MarkVerbeek91/AR2/docs/doc/source/requirements_document.rst

=====================
Requirement document
=====================

The program should have a graphical interface
The program should have a command line interface
The program should have a ROS interface

the user can create a new program
the user can load a existing program
the user can add a command to loaded program
the user can remove a command from the load program
the user can save the program 

the programmer can add program lines to a program list
the programmer can remove program lines from a program list
the programmer can send a program to the controller
the programmer is not blocked be the call to the controller
the programmer returns an error message when the controller is running 

the controller can send commands to the arduino
the controller can receive commands from the arduino
the controller has a running state
the controller has a stop state
