MarkVerbeek91/AR2/docs/doc/source/index.rst

.. AR2 documentation master file, created by
   sphinx-quickstart on Tue Nov 21 14:47:20 2017.
   You can adapt this file completely to your liking, but it should at least
   contain the root `toctree` directive.

Welcome to AR2's documentation!
===============================

.. toctree::
  :maxdepth: 2
  :caption: Contents:
    
  protocol
  uml_page

Here all documentation for the AR2 robotic arm made by Chriss Annin.  

Indices and tables
==================

* :ref:`genindex`
* :ref:`modindex`
* :ref:`search`
