MarkVerbeek91/AR2/docs/doc/source/protocol.rst

================
Serial protocol
================

+--------------+--------------+--------------+
| Main command | Function     | Parameters   |
+--------------+--------------+--------------+
| SV           | Turn on      |              |
+--------------+--------------+--------------+
| WT           |              |              |
+--------------+--------------+--------------+
| JF           |              |              |
+--------------+--------------+--------------+
| ON           |              |              |
+--------------+--------------+--------------+
| OF           |              |              |
+--------------+--------------+--------------+
| WI           |              |              |
+--------------+--------------+--------------+
| WO           |              |              |
+--------------+--------------+--------------+
| LL           |              |              |
+--------------+--------------+--------------+
| MJ           |              |              |
+--------------+--------------+--------------+

.. csv-table:: Protocol
  :widths: 4 20 20
  :header: "Main command", "Function", "Parameters"
  
  "SV", "Turn on/off servo", "Servo nr and servo position"
