MarkVerbeek91/AR2/AR2.1.4 kinematic model.xlsm

FORWARD KINAMATICS |  |  |  |  |  |  |  |  |  | INVERSE KINAMATICS
 | IN |  |  |  |  |  | OUT |  |  |  | IN
 | degrees | radians
J1 * ( -170 / 170 ) | 0.0001 | 1.745329252e-06 |  |  |  | X | 68.71814224 |  |  | X | 68.71814224 | J1 | 9.999999996e-05
J2 * ( -132 / 0 ) | -90 | -1.570796327 |  |  |  | Y | 0.0001199357837 |  |  | Y | 0.0001199357837 | J2 | -90
J3 * ( 1 / 140 ) | 1 | -1.553343034 |  |  |  | Z | 733.6105702 |  |  | Z | 733.6105702 | J3 | 1
 | 0 | 0 |  |  |  | y | -90 | -1.570796327 |  | y | -90 | J4 | -3.113901077e-10 | -3.113901077e-10 | 180
 | 0.0001 | 1.745329252e-06 |  |  |  | p | 1.0001 | 0.01745503785 |  | p | 1.0001 | J5 | 9.999727019e-05 | 9.999727019e-05 | -9.999727019e-05 |  | WRIST CONF. | "F"
 | 0 | 3.141592654 |  |  |  | r | -90.0001 | -1.570798072 |  | r | -90.0001 | J6 | 3.113598268e-10 | 3.113598268e-10 | -180 |  | QUADRANT | 1
 | DH params
 | joint | Θ | α | d | a |  | WORK FRAME |  | TOOL FRAME | CALCULATE J1 ANGLE
 | 1 | 1.745329252e-06 | -1.570796327 | 169.77 | 64.2 | X | 0 | X | 0 | J1 ∠ | 1.745329251e-06 | 9.999999996e-05
 | 2 | -1.570796327 | 0 | 0 | 305 | Y | 0 | Y | 0
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
