MarkVerbeek91/AR2/CAD/J5 main bearing housing.STEP

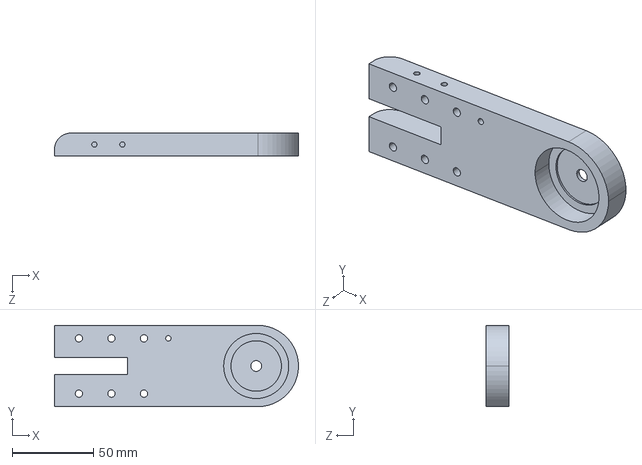
[picture p1: CAD file, 2017-11-05]
CAD/J5 main bearing housing.STEP
150.0 x 50.0 x 14.0 mm
