MarkVerbeek91/AR2/CAD/J6 main bearing arm.STEP

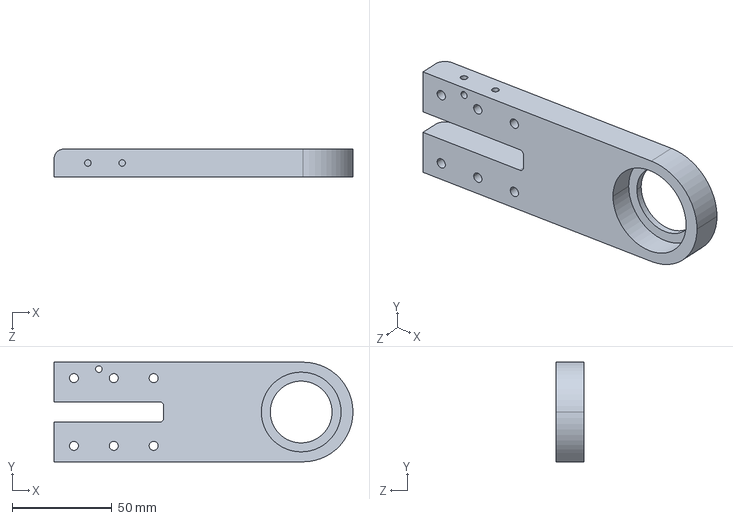
[picture p2: CAD file, 2017-11-05]
CAD/J6 main bearing arm.STEP
150.0 x 50.0 x 14.0 mm
