MarkVerbeek91/AR2/CAD/J4 main shaft.STEP

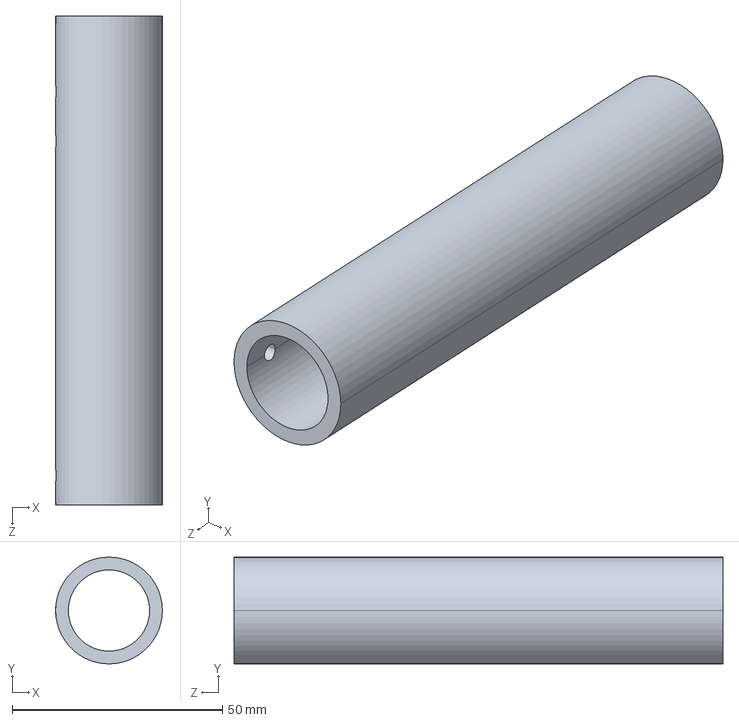
[picture p3: CAD file, 2017-11-05]
CAD/J4 main shaft.STEP
25.4 x 25.4 x 116.3 mm
