MarkVerbeek91/AR2/CAD/J2 turret housing.STEP

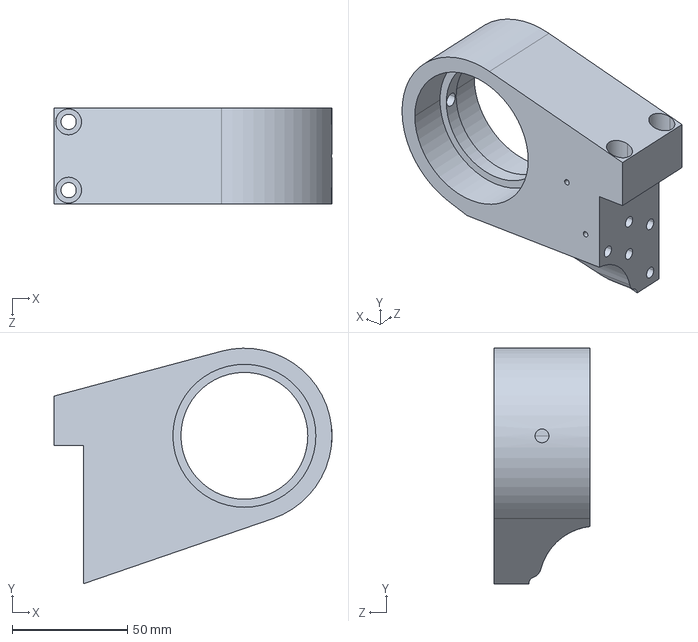
[picture p4: CAD file, 2017-11-05]
CAD/J2 turret housing.STEP
120.6 x 102.2 x 41.6 mm
