MarkVerbeek91/AR2/stl/J2 arm part 1.STL

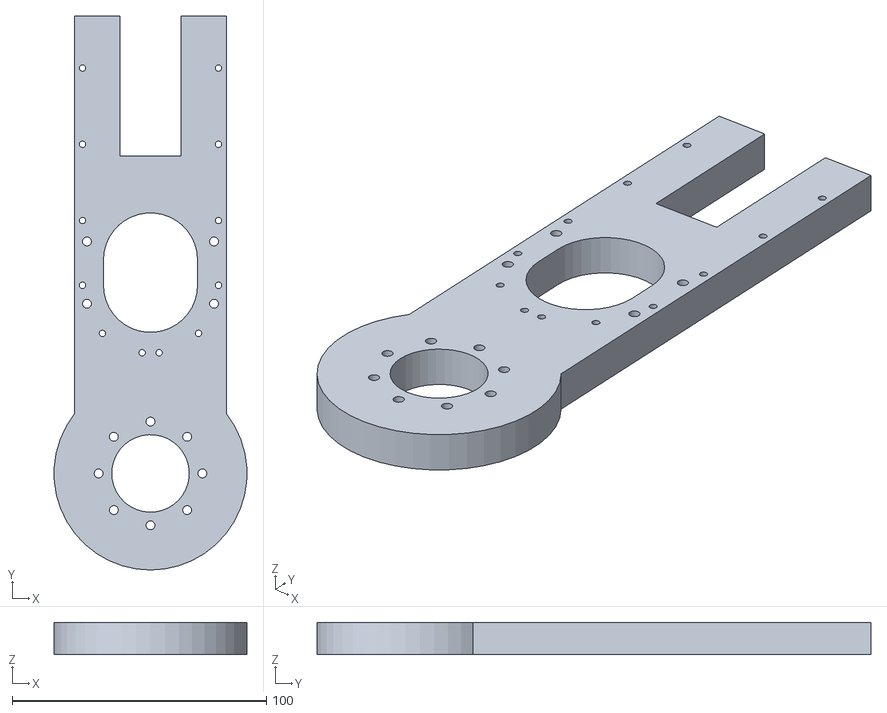
[picture p5: CAD file, 2017-11-05]
stl/J2 arm part 1.STL
75.8 x 218.0 x 12.7
