MarkVerbeek91/AR2/CAD/J2 drive spindle .STEP

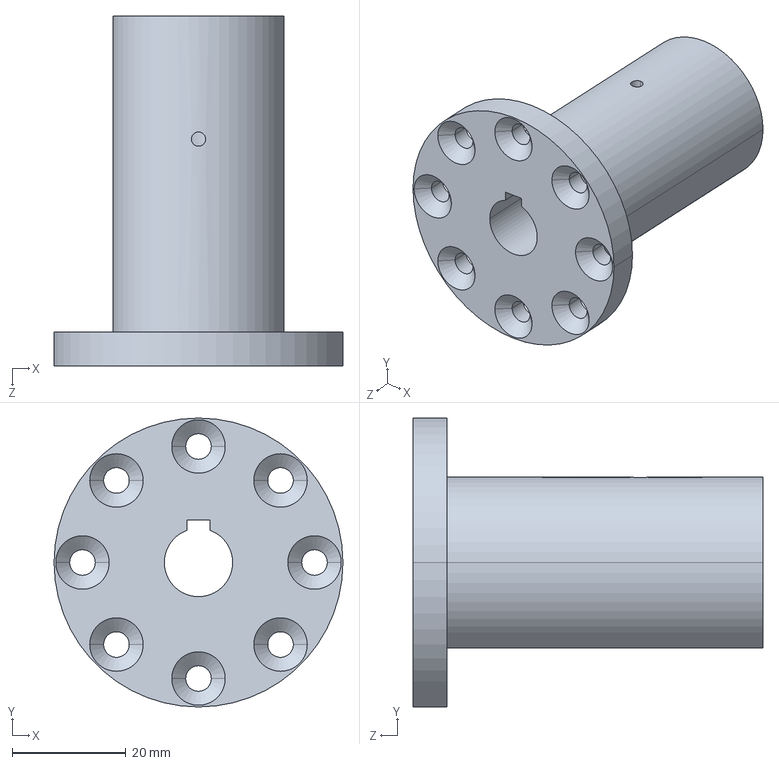
[picture p6: CAD file, 2017-11-05]
CAD/J2 drive spindle .STEP
50.8 x 50.8 x 61.5 mm
