MarkVerbeek91/AR2/stl/J2 tension ring - 14mm for precision GB.STL

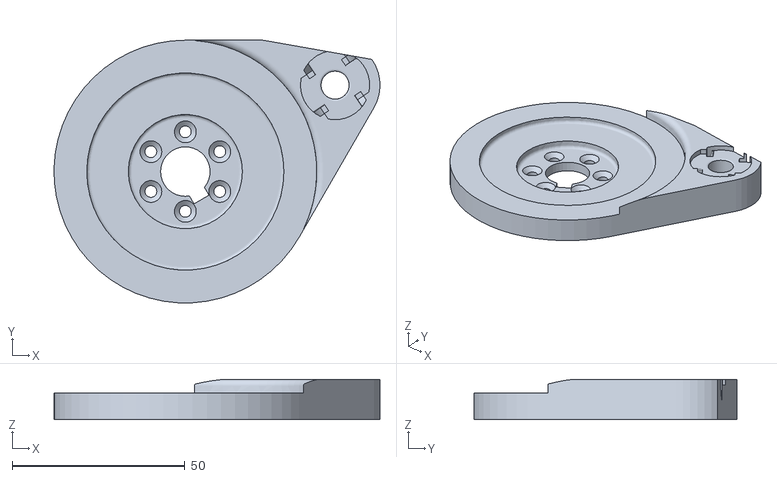
[picture p7: CAD file, 2017-11-05]
stl/J2 tension ring - 14mm for precision GB.STL
94.3 x 75.9 x 11.7
