MarkVerbeek91/AR2/stl/J1 spindle center alignment plug.STL

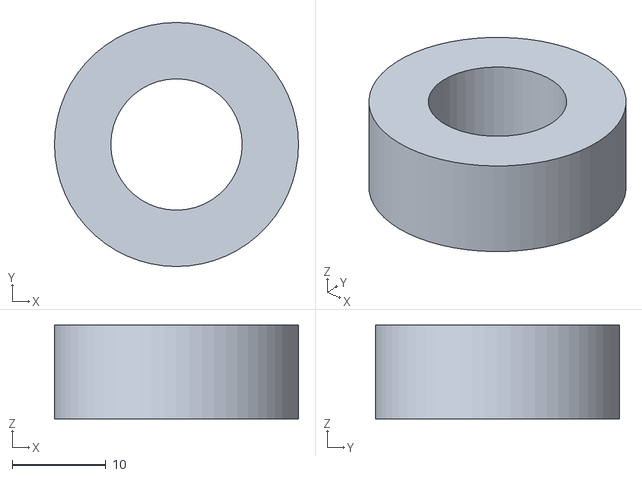
[picture p8: CAD file, 2017-11-05]
stl/J1 spindle center alignment plug.STL
26.0 x 26.0 x 10.0
