MarkVerbeek91/AR2/CAD/J5 side cover.STEP

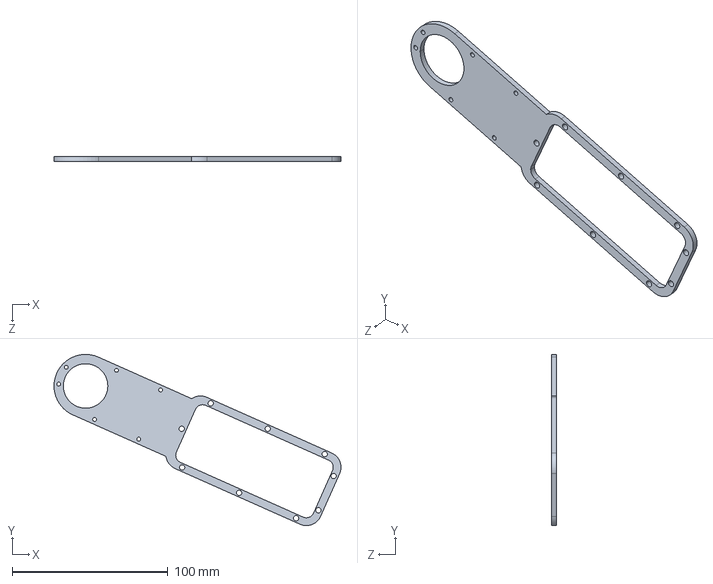
[picture p9: CAD file, 2017-11-05]
CAD/J5 side cover.STEP
184.0 x 109.7 x 3.17 mm
