MarkVerbeek91/AR2/stl/J1 base support spacer part 1.STL

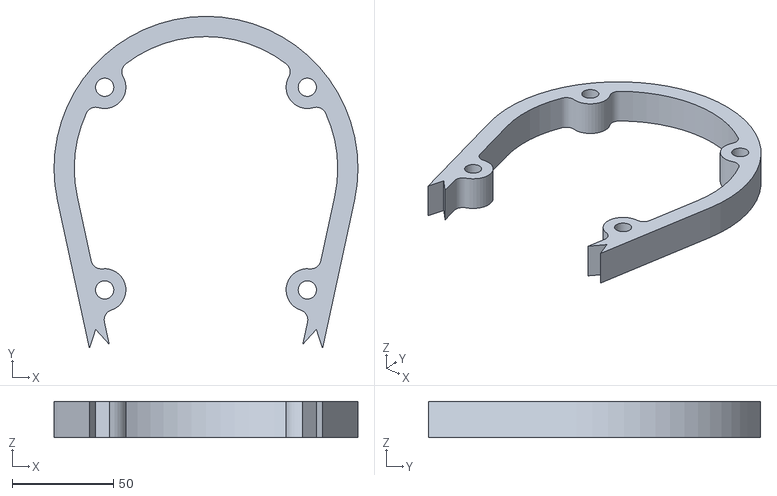
[picture p10: CAD file, 2017-11-05]
stl/J1 base support spacer part 1.STL
150.0 x 164.0 x 18.0
