MarkVerbeek91/AR2/CAD/J1 turret platform.STEP

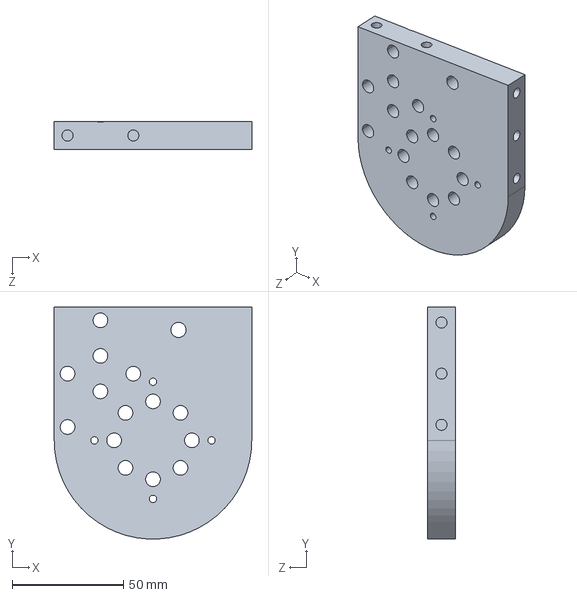
[picture p11: CAD file, 2017-11-05]
CAD/J1 turret platform.STEP
88.9 x 104.4 x 12.7 mm
