MarkVerbeek91/AR2/stl/J1 base plate part 1.STL

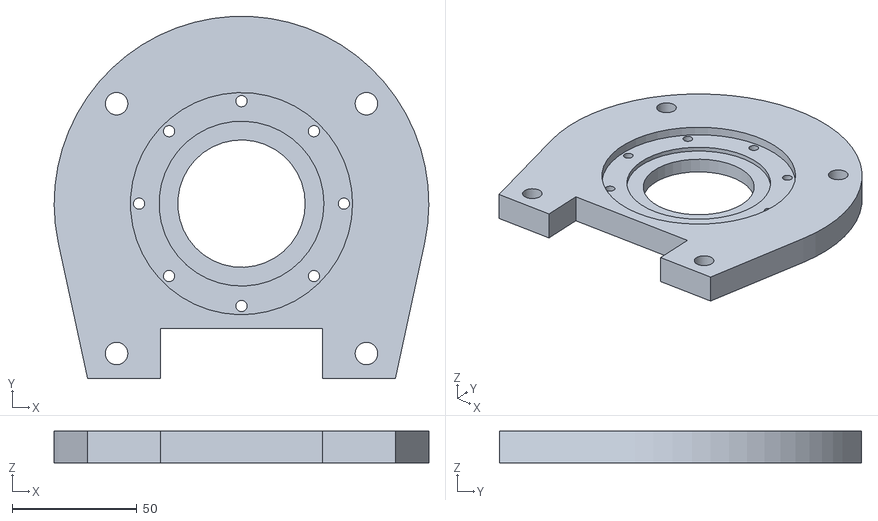
[picture p12: CAD file, 2017-11-05]
stl/J1 base plate part 1.STL
150.0 x 144.9 x 12.7
