MarkVerbeek91/AR2/CAD/J2 arm cover spacer.STEP

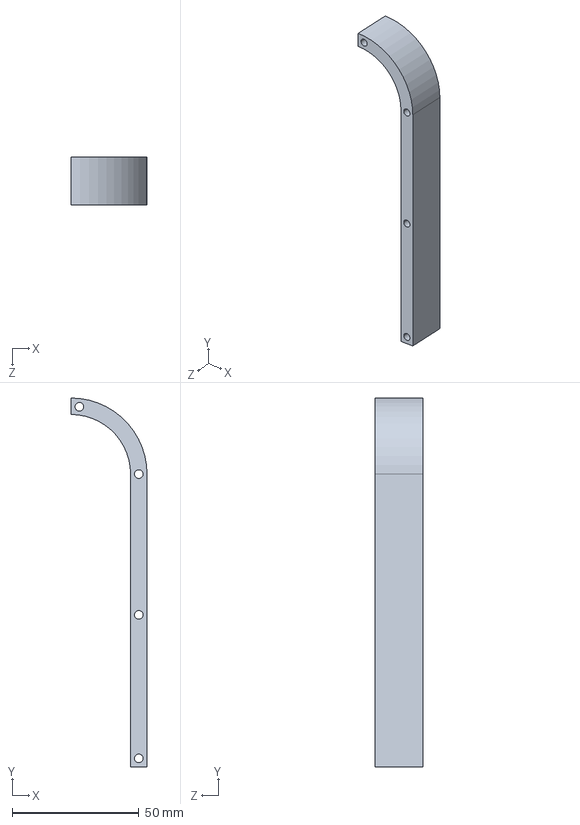
[picture p13: CAD file, 2017-11-05]
CAD/J2 arm cover spacer.STEP
30.0 x 145.5 x 19.1 mm
