MarkVerbeek91/AR2/stl/J1 base plate part 2.STL

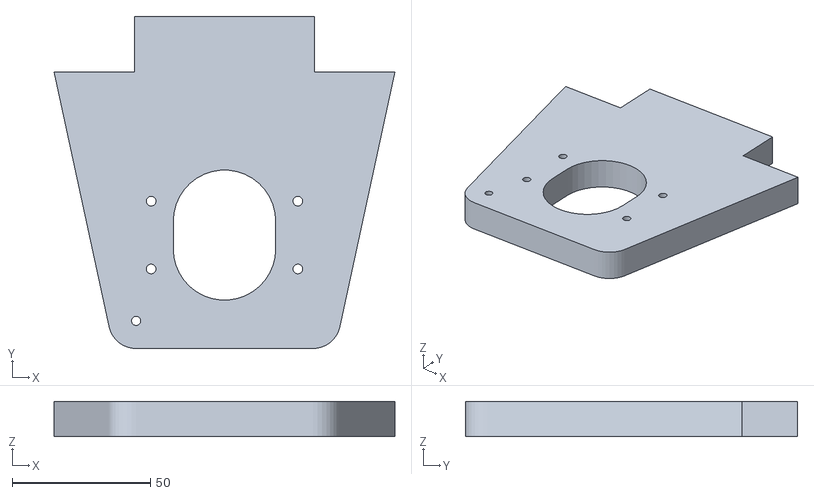
[picture p14: CAD file, 2017-11-05]
stl/J1 base plate part 2.STL
123.2 x 120.0 x 12.7
