MarkVerbeek91/AR2/CAD/J3 spindle.STEP

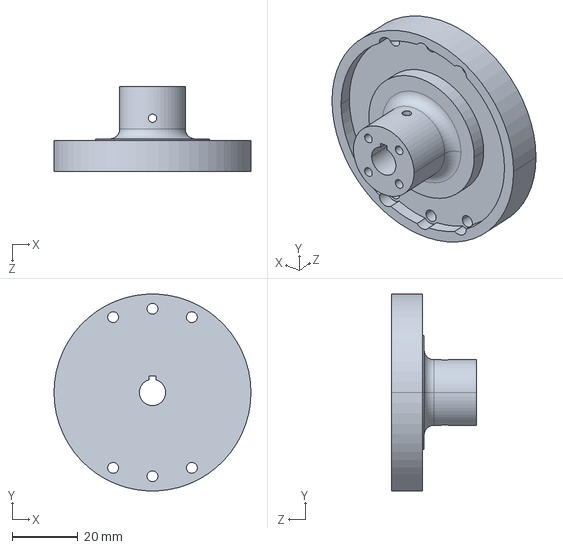
[picture p15: CAD file, 2017-11-05]
CAD/J3 spindle.STEP
60.0 x 59.9 x 26.0 mm
