MarkVerbeek91/AR2/stl/J2 arm part 2.STL

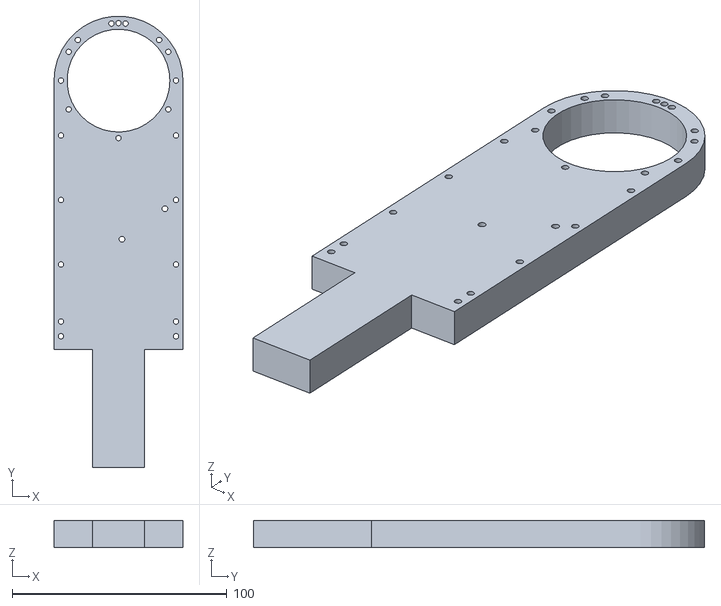
[picture p16: CAD file, 2017-11-05]
stl/J2 arm part 2.STL
60.0 x 209.9 x 12.7
