MarkVerbeek91/AR2/CAD/J6 bearing cap.STEP

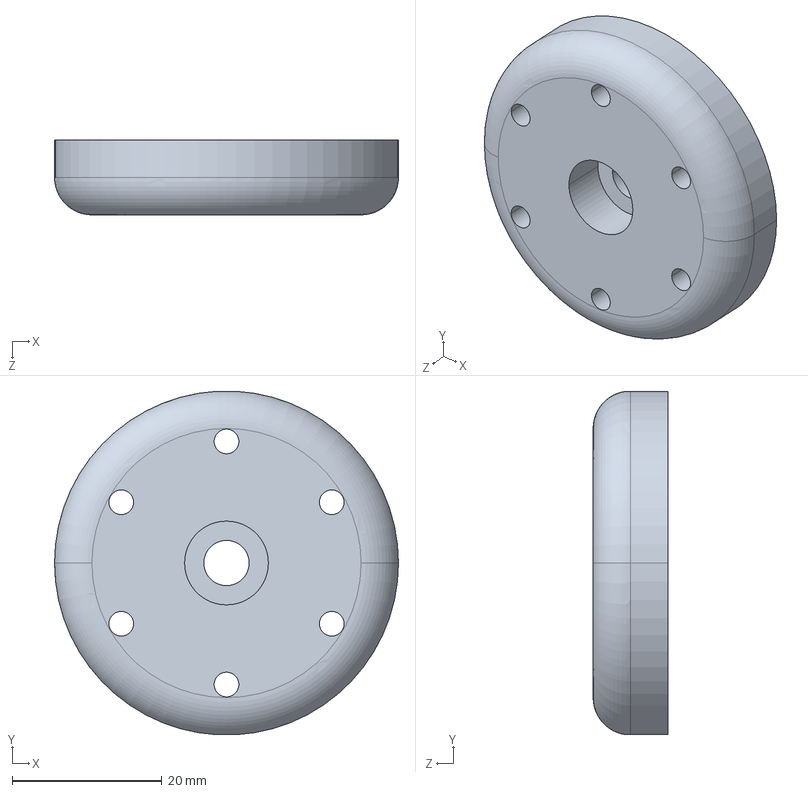
[picture p17: CAD file, 2017-11-05]
CAD/J6 bearing cap.STEP
46.0 x 45.9 x 10.0 mm
