MarkVerbeek91/AR2/stl/auxilliary J2 arm support.STL

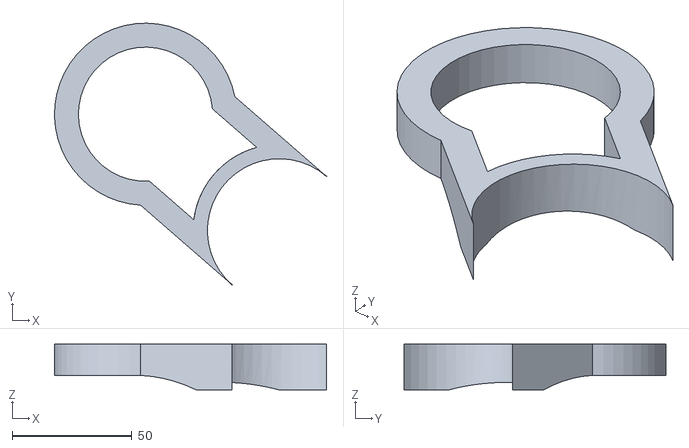
[picture p18: CAD file, 2017-11-05]
stl/auxilliary J2 arm support.STL
113.5 x 109.2 x 19.0
