MarkVerbeek91/AR2/CAD/J3 bearing cup.STEP

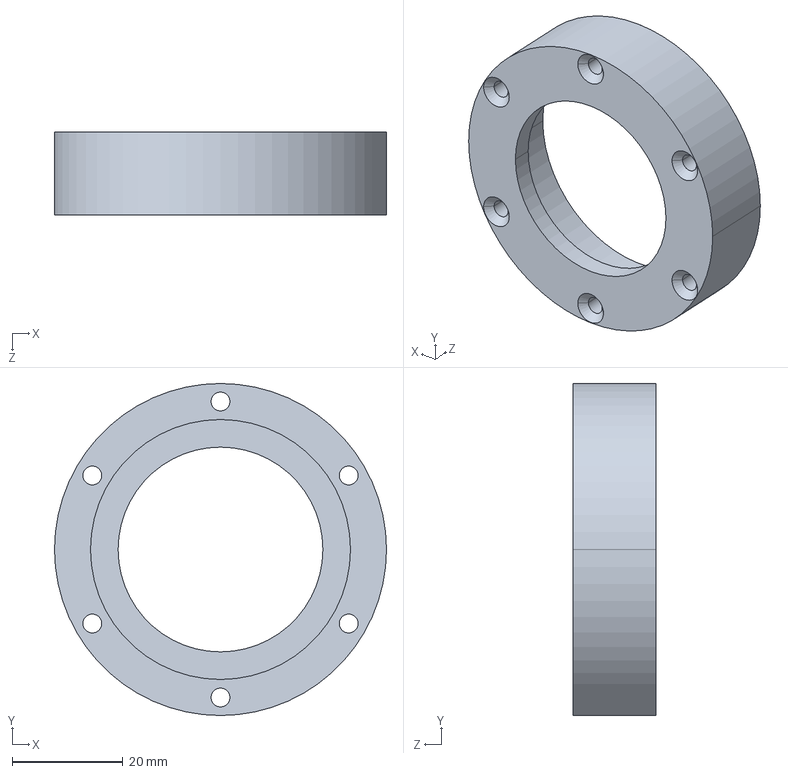
[picture p19: CAD file, 2017-11-05]
CAD/J3 bearing cup.STEP
60.0 x 60.0 x 15.0 mm
