MarkVerbeek91/AR2/stl/auxilliary spring housing support.STL

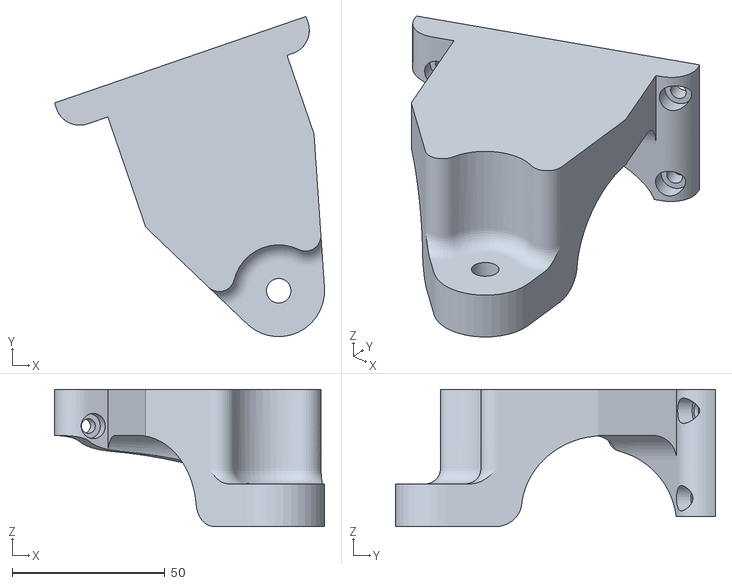
[picture p20: CAD file, 2017-11-05]
stl/auxilliary spring housing support.STL
88.3 x 104.6 x 44.9
