MarkVerbeek91/AR2/CAD/J5 idler tension block.STEP

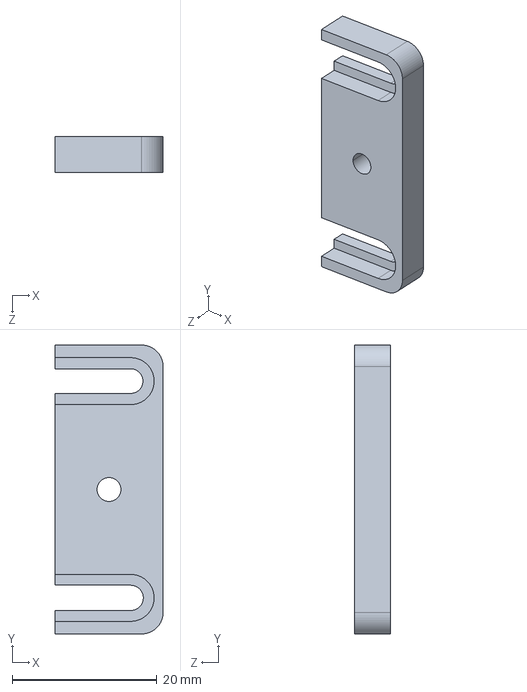
[picture p21: CAD file, 2017-11-05]
CAD/J5 idler tension block.STEP
15.0 x 40.0 x 5.00 mm
