MarkVerbeek91/AR2/stl/J2 drive spindle - 14mm for precision GB .STL

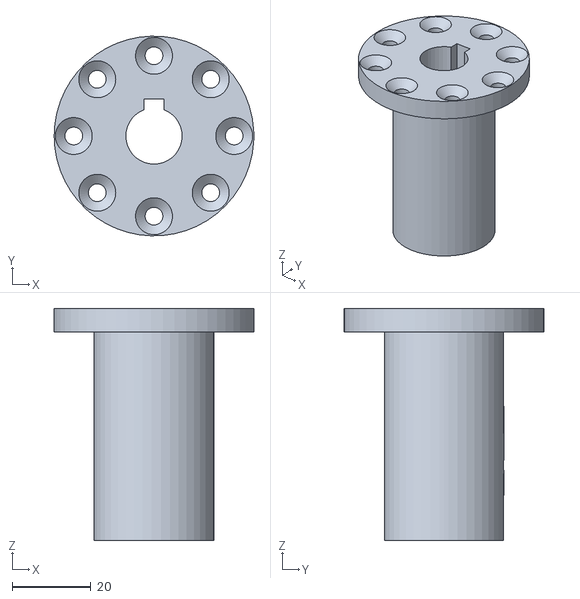
[picture p22: CAD file, 2017-11-05]
stl/J2 drive spindle - 14mm for precision GB .STL
50.8 x 50.8 x 59.0
