MarkVerbeek91/AR2/CAD/J5 belt carrier clamp.STEP

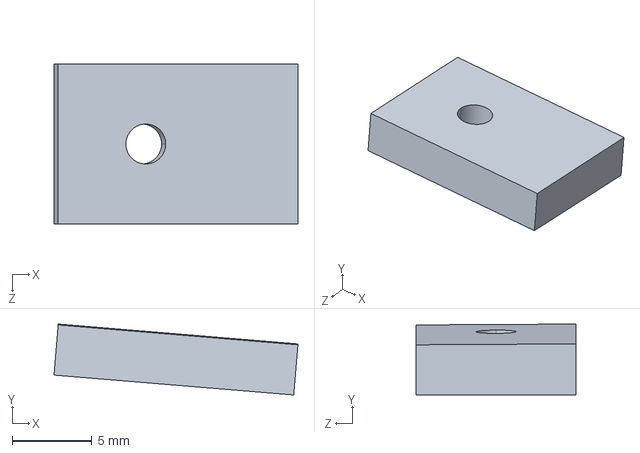
[picture p23: CAD file, 2017-11-05]
CAD/J5 belt carrier clamp.STEP
15.3 x 4.44 x 10.0 mm
