MarkVerbeek91/AR2/stl/auxilliary platform support.STL

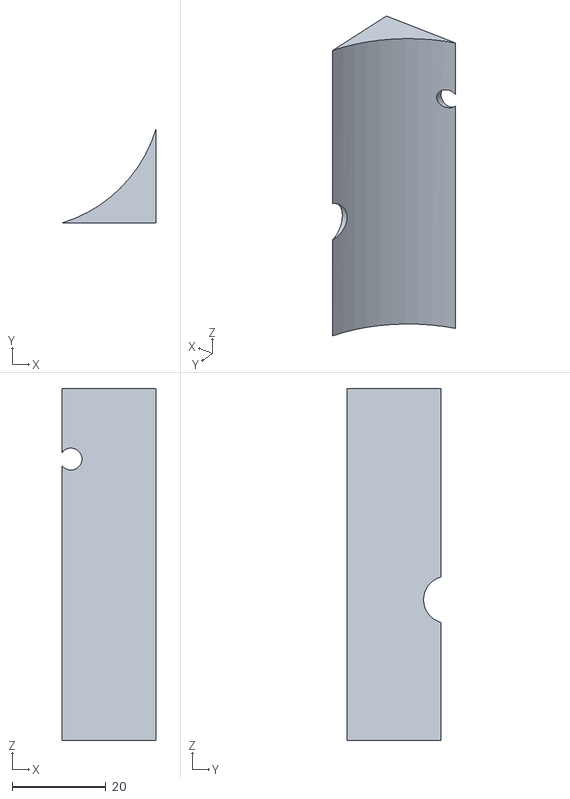
[picture p24: CAD file, 2017-11-05]
stl/auxilliary platform support.STL
20.0 x 20.0 x 75.0
