MarkVerbeek91/AR2/CAD/J6 Limit Switch Tip.STEP

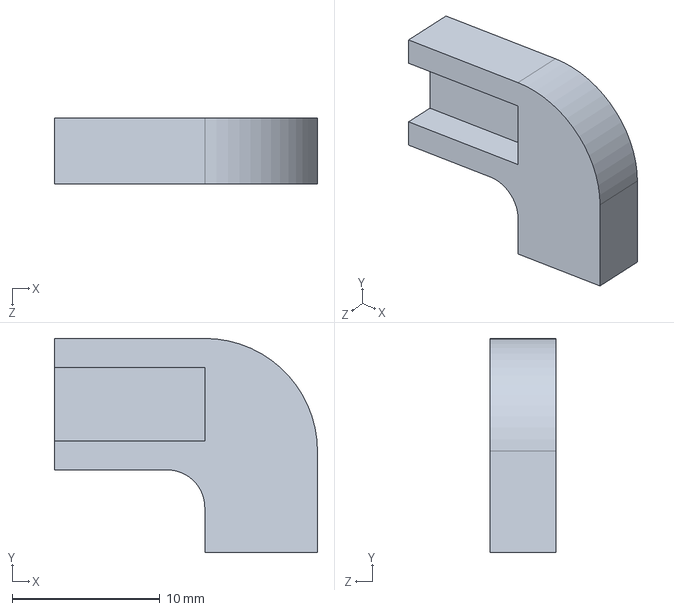
[picture p25: CAD file, 2017-11-05]
CAD/J6 Limit Switch Tip.STEP
17.8 x 14.5 x 4.44 mm
