MarkVerbeek91/AR2/stl/J2 spring plunger.STL

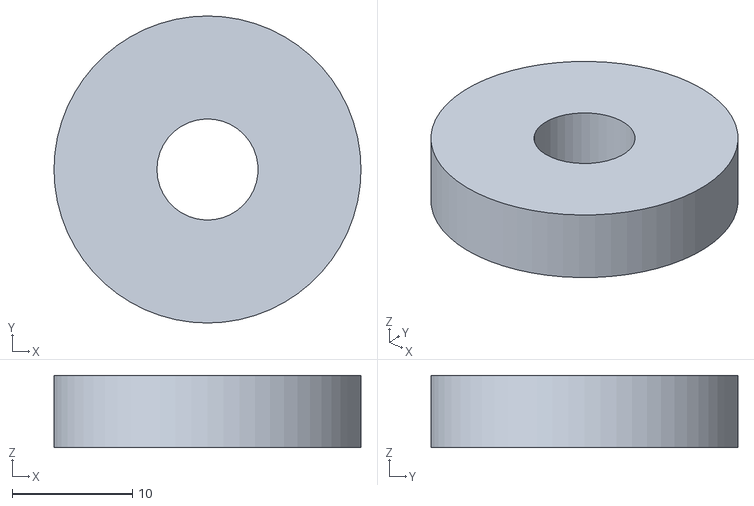
[picture p26: CAD file, 2017-11-05]
stl/J2 spring plunger.STL
25.5 x 25.5 x 6.00
