MarkVerbeek91/AR2/CAD/J1 turret housing.STEP

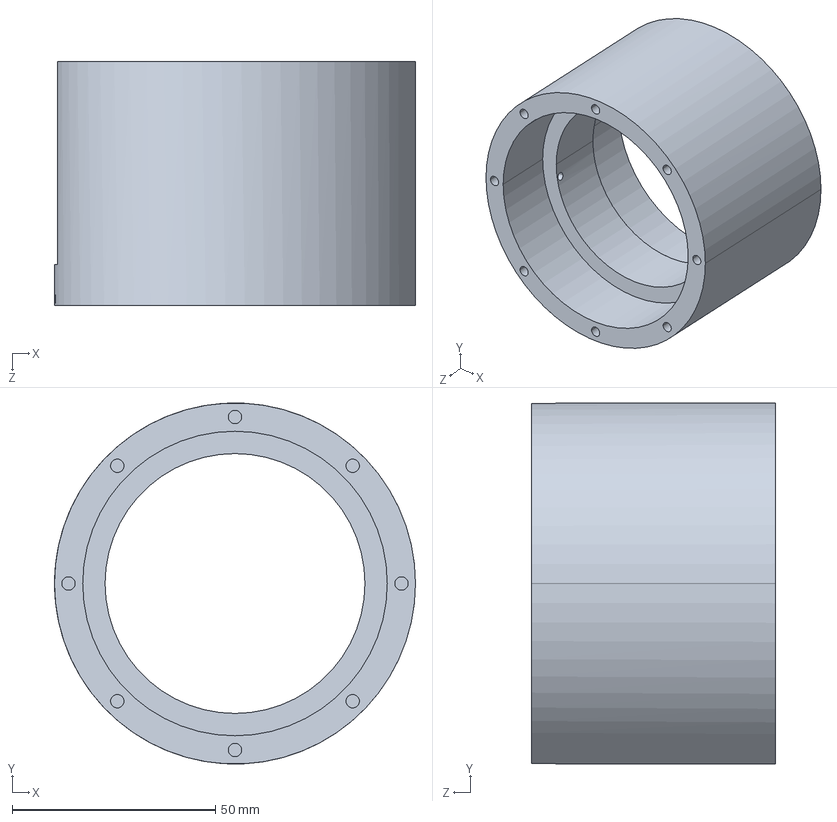
[picture p27: CAD file, 2017-11-05]
CAD/J1 turret housing.STEP
88.9 x 88.8 x 60.0 mm
