MarkVerbeek91/AR2/stl/J2 side cover half .STL

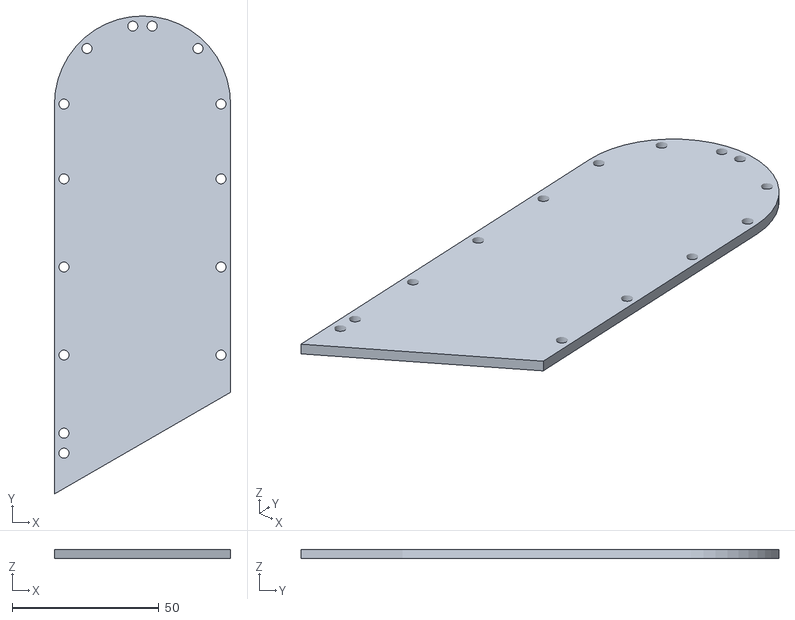
[picture p28: CAD file, 2017-11-05]
stl/J2 side cover half .STL
60.0 x 162.8 x 3.17
