MarkVerbeek91/AR2/CAD/J4 timing hub.STEP

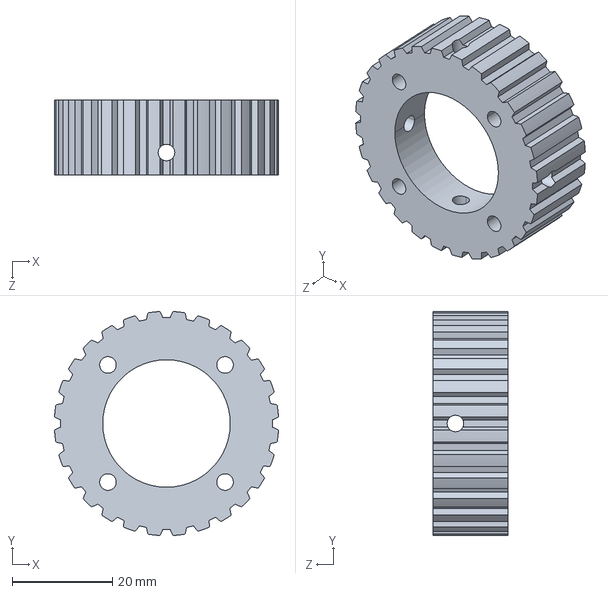
[picture p29: CAD file, 2017-11-05]
CAD/J4 timing hub.STEP
44.6 x 44.6 x 15.0 mm
