MarkVerbeek91/AR2/stl/J6 drive post.STL

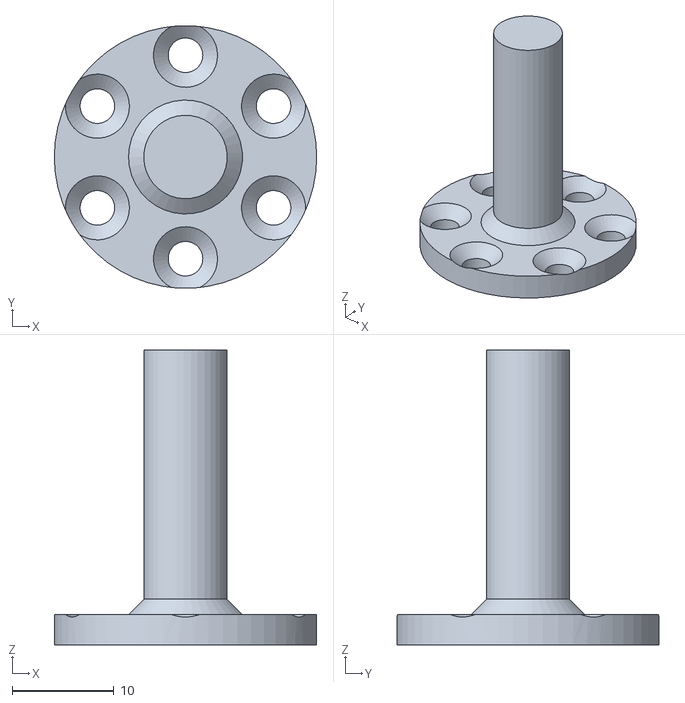
[picture p30: CAD file, 2017-11-05]
stl/J6 drive post.STL
25.8 x 25.8 x 29.0
