MarkVerbeek91/AR2/CAD/J3 motor mount.STEP

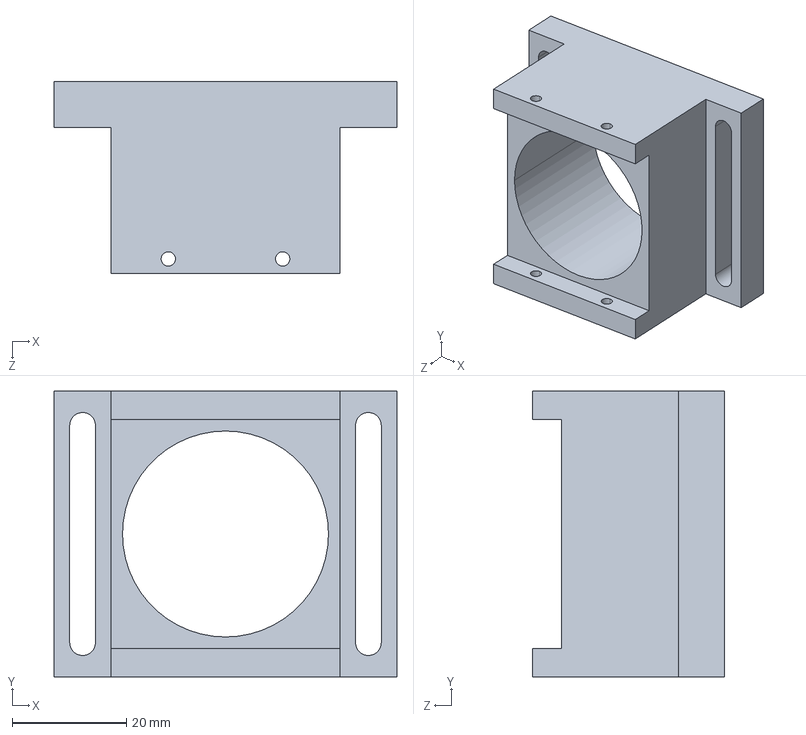
[picture p31: CAD file, 2017-11-05]
CAD/J3 motor mount.STEP
60.0 x 50.0 x 33.5 mm
