MarkVerbeek91/AR2/stl/J6 Housing.STL

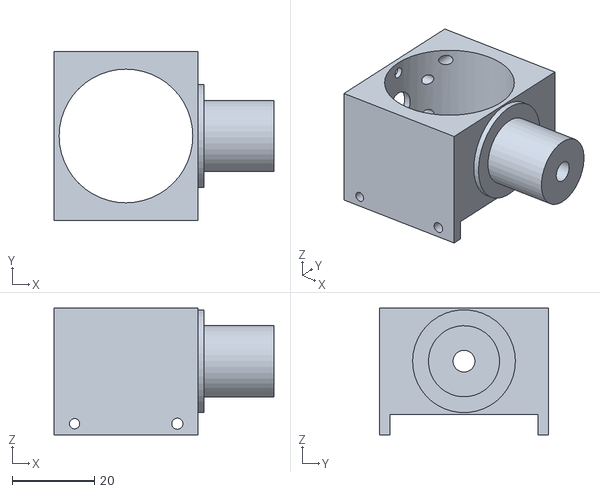
[picture p32: CAD file, 2017-11-05]
stl/J6 Housing.STL
53.5 x 41.0 x 30.8
