MarkVerbeek91/AR2/CAD/J5 bearing post.STEP

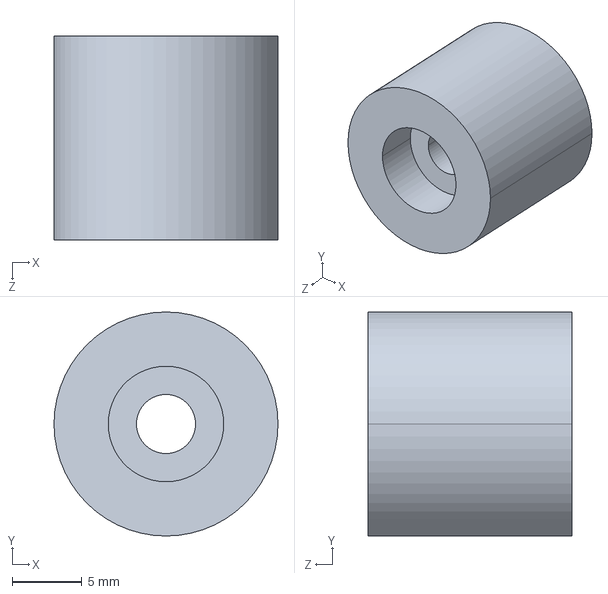
[picture p33: CAD file, 2017-11-05]
CAD/J5 bearing post.STEP
16.0 x 16.0 x 14.6 mm
