MarkVerbeek91/AR2/stl/auxilliary base support.STL

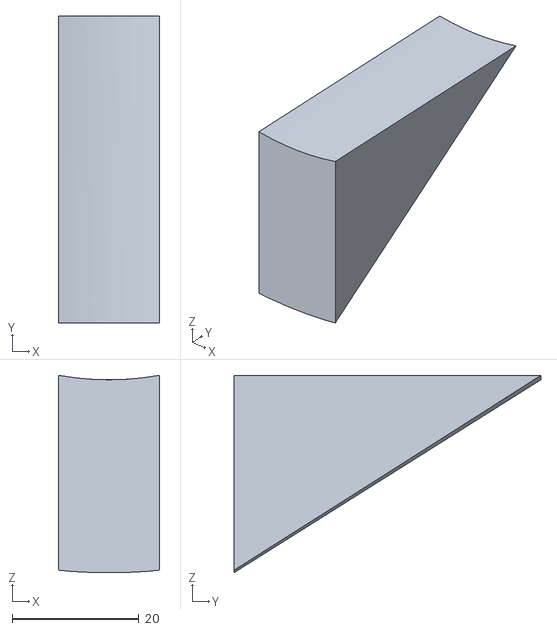
[picture p34: CAD file, 2017-11-05]
stl/auxilliary base support.STL
16.0 x 48.5 x 31.2
