MarkVerbeek91/AR2/stl/J1 base support spacer part 2.STL

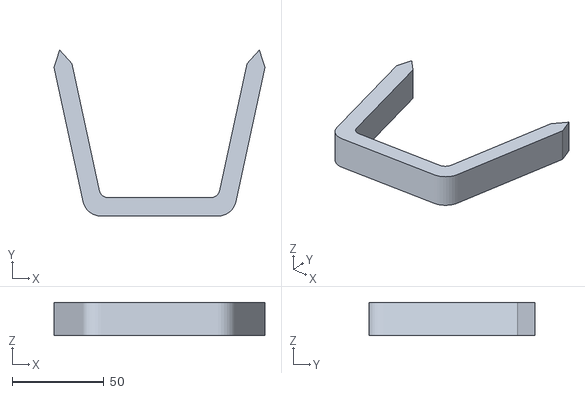
[picture p35: CAD file, 2017-11-05]
stl/J1 base support spacer part 2.STL
115.0 x 90.5 x 18.0
