MarkVerbeek91/AR2/CAD/J5 belt carrier.STEP

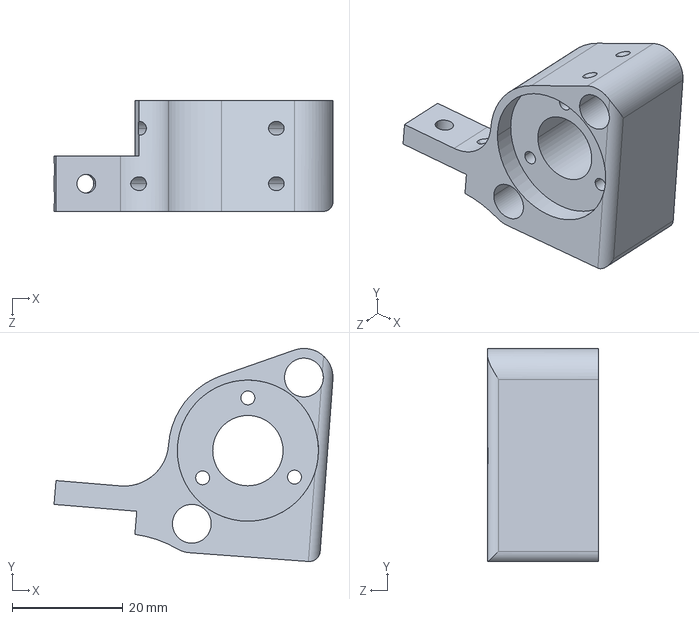
[picture p36: CAD file, 2017-11-05]
CAD/J5 belt carrier.STEP
50.4 x 38.5 x 20.0 mm
