MarkVerbeek91/AR2/CAD/J3 limit arm.STEP

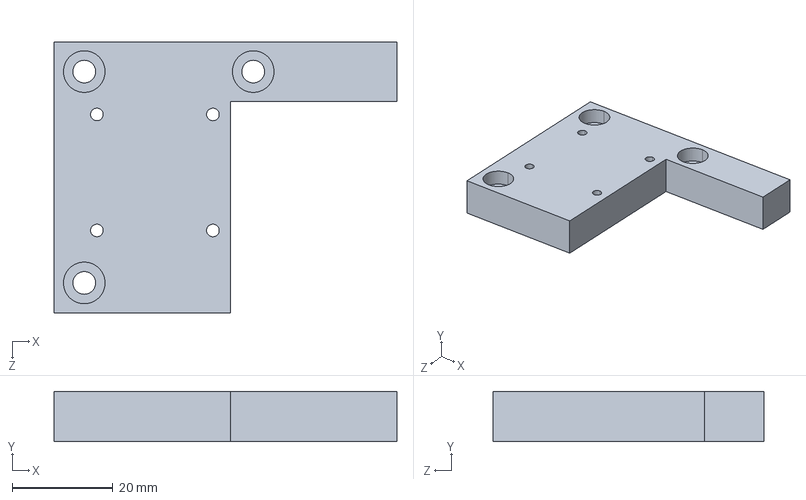
[picture p37: CAD file, 2017-11-05]
CAD/J3 limit arm.STEP
68.0 x 10.0 x 53.8 mm
