MarkVerbeek91/AR2/CAD/J2 tension ring.STEP

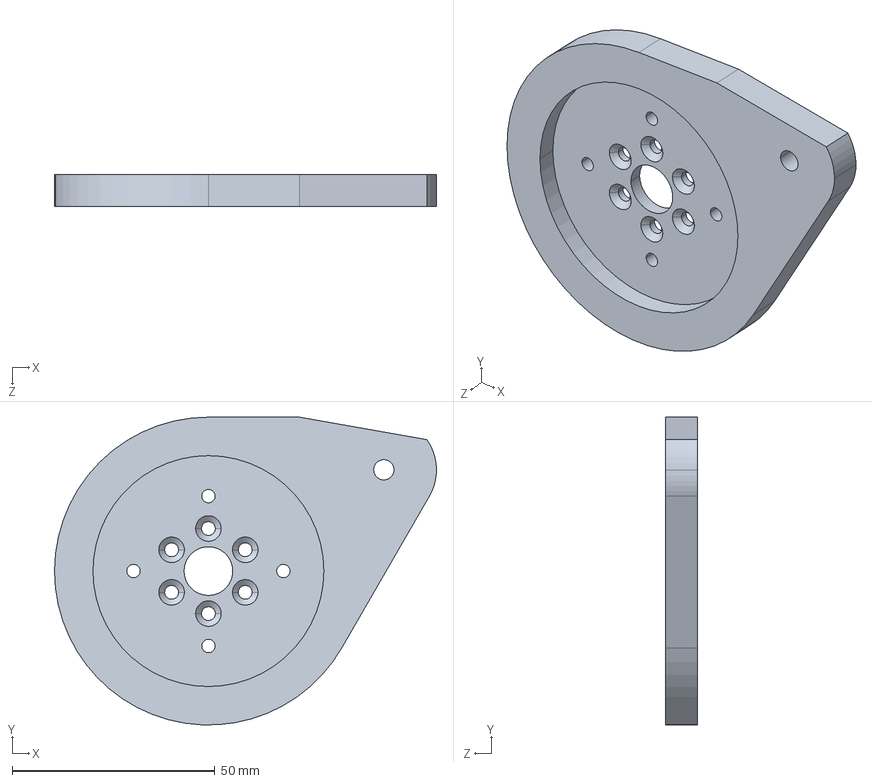
[picture p38: CAD file, 2017-11-05]
CAD/J2 tension ring.STEP
94.3 x 76.0 x 7.94 mm
