MarkVerbeek91/AR2/CAD/J5 side cover spacer.STEP

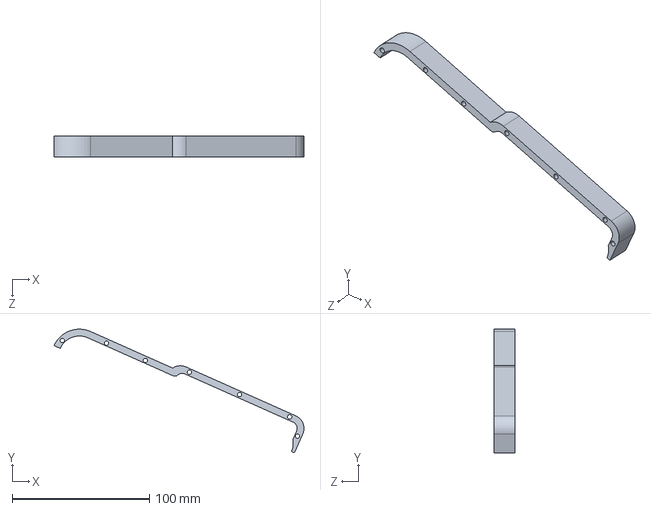
[picture p39: CAD file, 2017-11-05]
CAD/J5 side cover spacer.STEP
182.2 x 90.1 x 15.0 mm
