MarkVerbeek91/AR2/CAD/J1 base plate.STEP

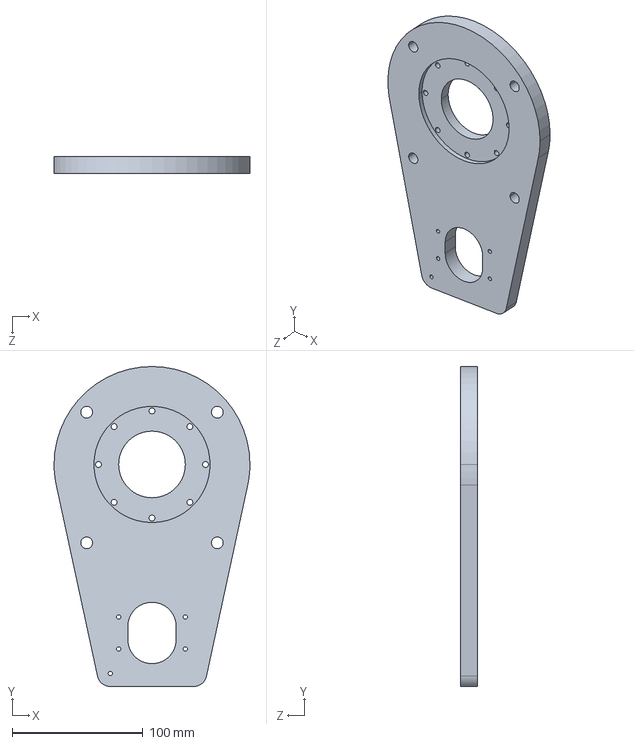
[picture p40: CAD file, 2017-11-05]
CAD/J1 base plate.STEP
150.0 x 245.0 x 12.7 mm
