MarkVerbeek91/AR2/CAD/J4 turret housing.STEP

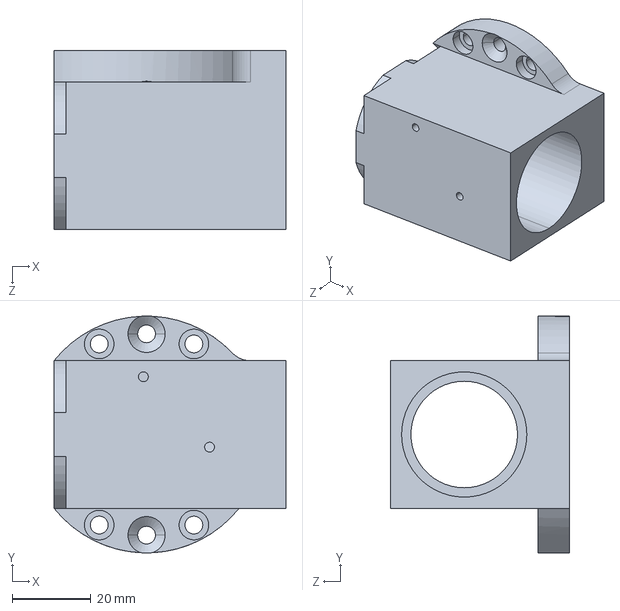
[picture p41: CAD file, 2017-11-05]
CAD/J4 turret housing.STEP
58.8 x 60.0 x 45.4 mm
