MarkVerbeek91/AR2/CAD/J6 gripper mount.STEP

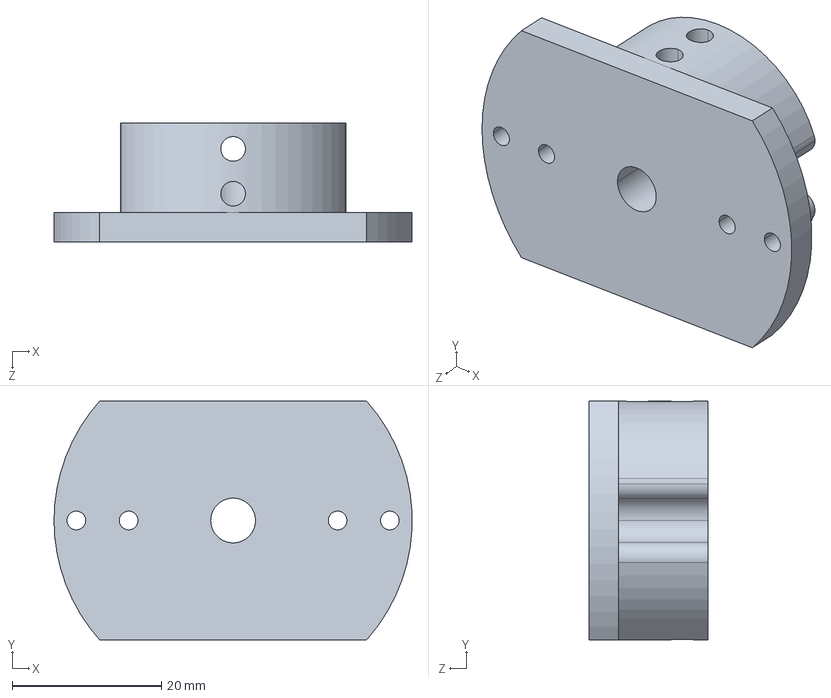
[picture p42: CAD file, 2017-11-05]
CAD/J6 gripper mount.STEP
48.0 x 32.0 x 16.0 mm
