MarkVerbeek91/AR2/CAD/J5 motor mount.STEP

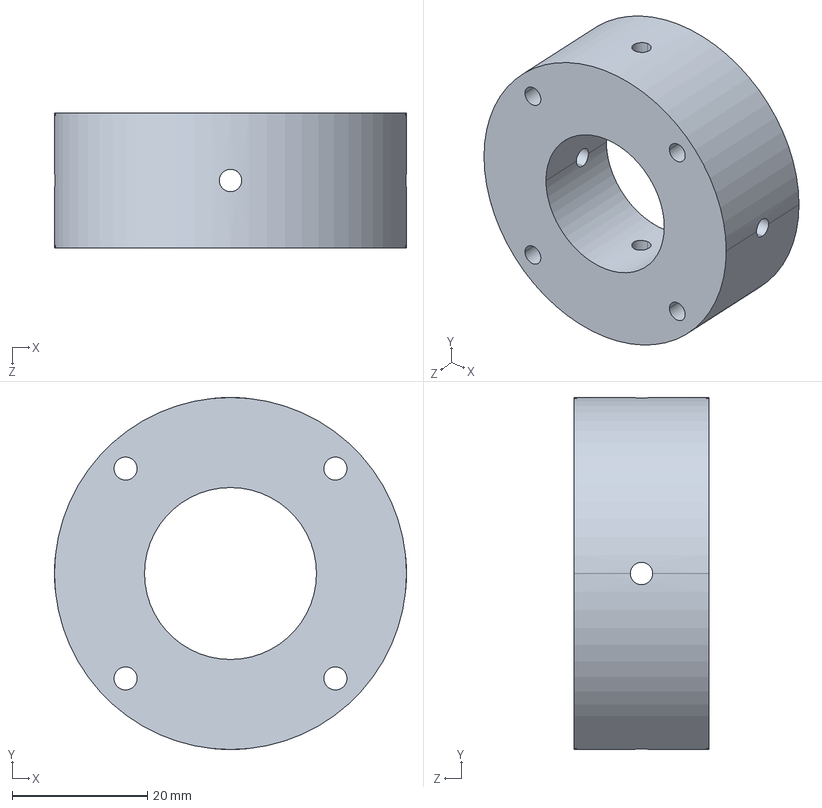
[picture p43: CAD file, 2017-11-05]
CAD/J5 motor mount.STEP
52.0 x 52.0 x 20.0 mm
