MarkVerbeek91/AR2/CAD/J2 motor support - precision GB.STEP

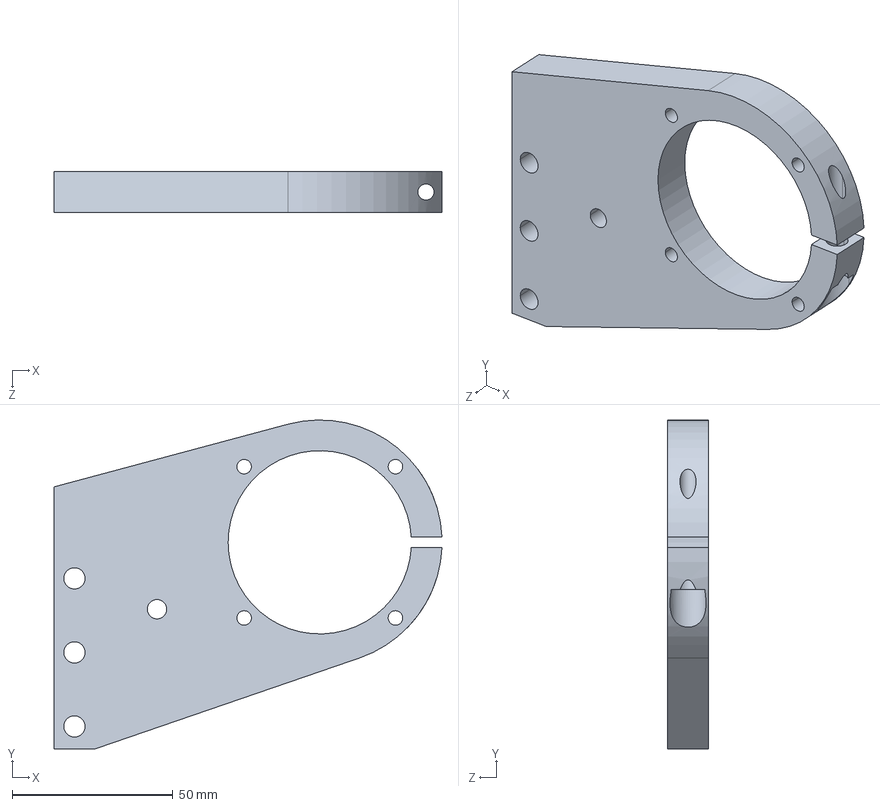
[picture p44: CAD file, 2017-11-05]
CAD/J2 motor support - precision GB.STEP
120.5 x 102.2 x 12.7 mm
