MarkVerbeek91/AR2/CAD/J1 motor mount.STEP

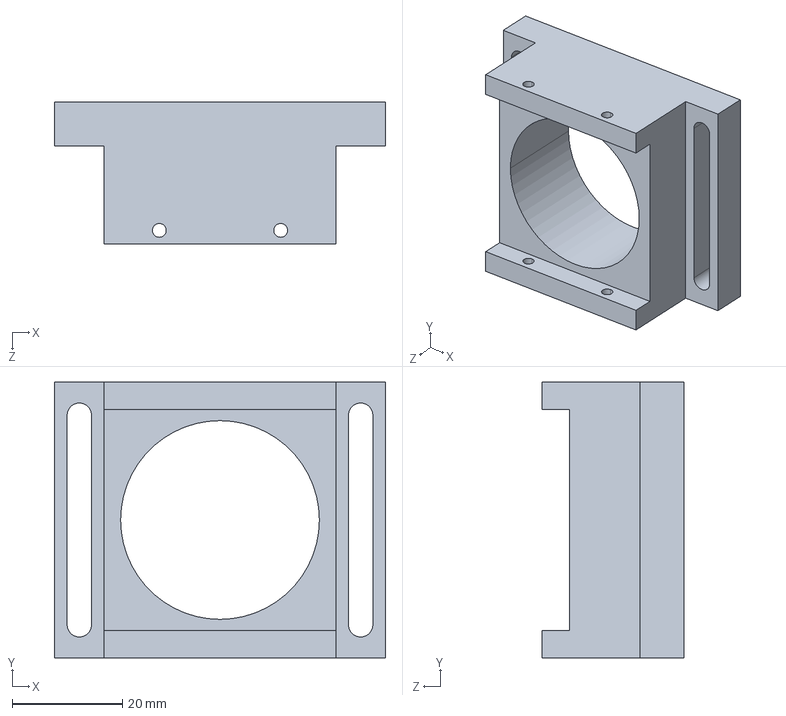
[picture p45: CAD file, 2017-11-05]
CAD/J1 motor mount.STEP
60.0 x 50.0 x 25.8 mm
