MarkVerbeek91/AR2/CAD/J5 side cover cap.STEP

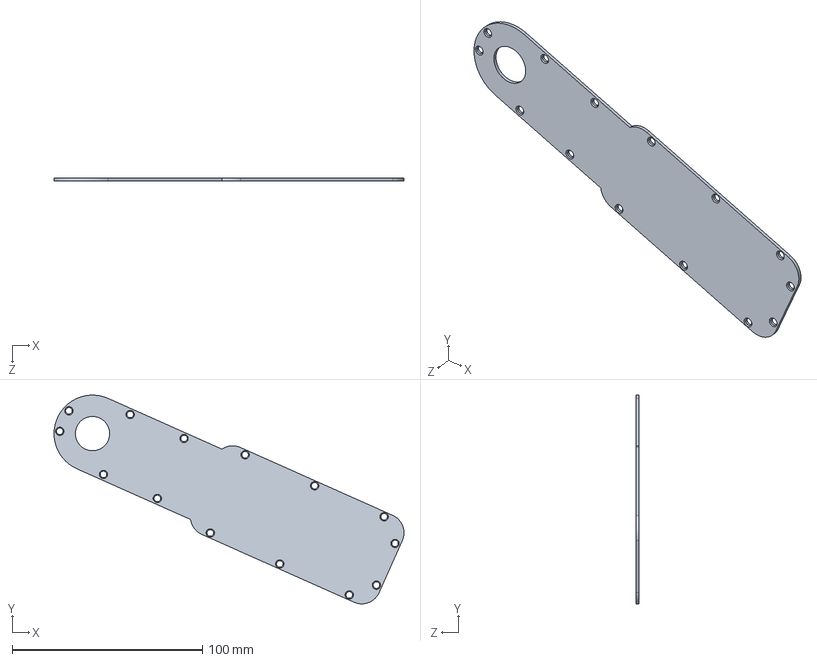
[picture p46: CAD file, 2017-11-05]
CAD/J5 side cover cap.STEP
184.0 x 109.7 x 1.59 mm
