MarkVerbeek91/AR2/CAD/J1 spindle.STEP

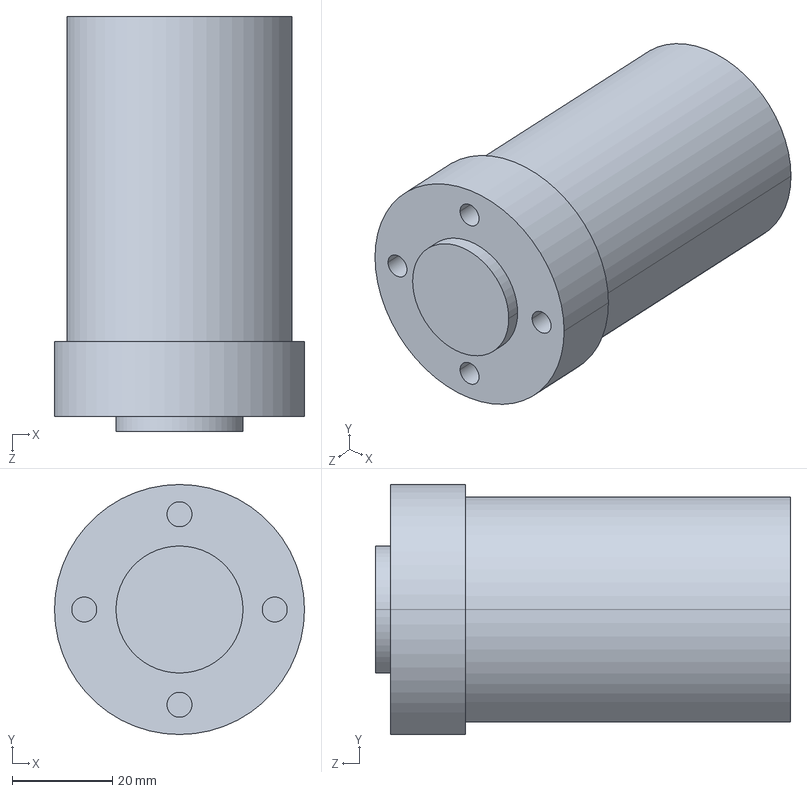
[picture p47: CAD file, 2017-11-05]
CAD/J1 spindle.STEP
50.0 x 50.0 x 83.0 mm
