MarkVerbeek91/AR2/CAD/J1 & J3 motor mount - precision GB.STEP

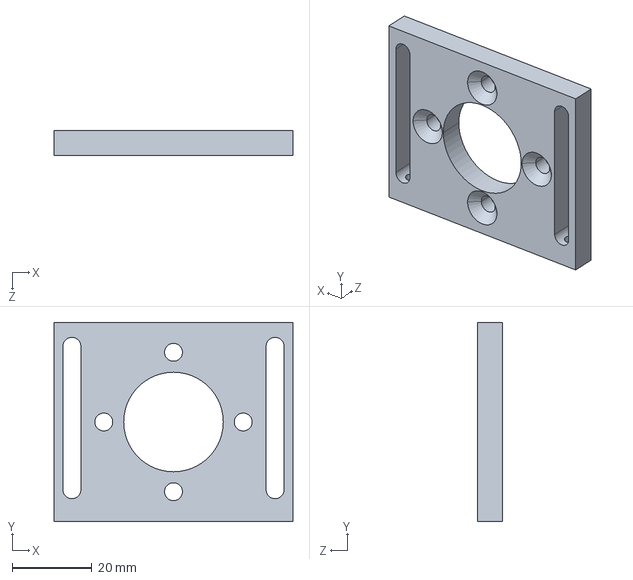
[picture p48: CAD file, 2017-11-05]
CAD/J1 & J3 motor mount - precision GB.STEP
60.0 x 50.0 x 6.35 mm
