MarkVerbeek91/AR2/CAD/J1 base support spacer.STEP

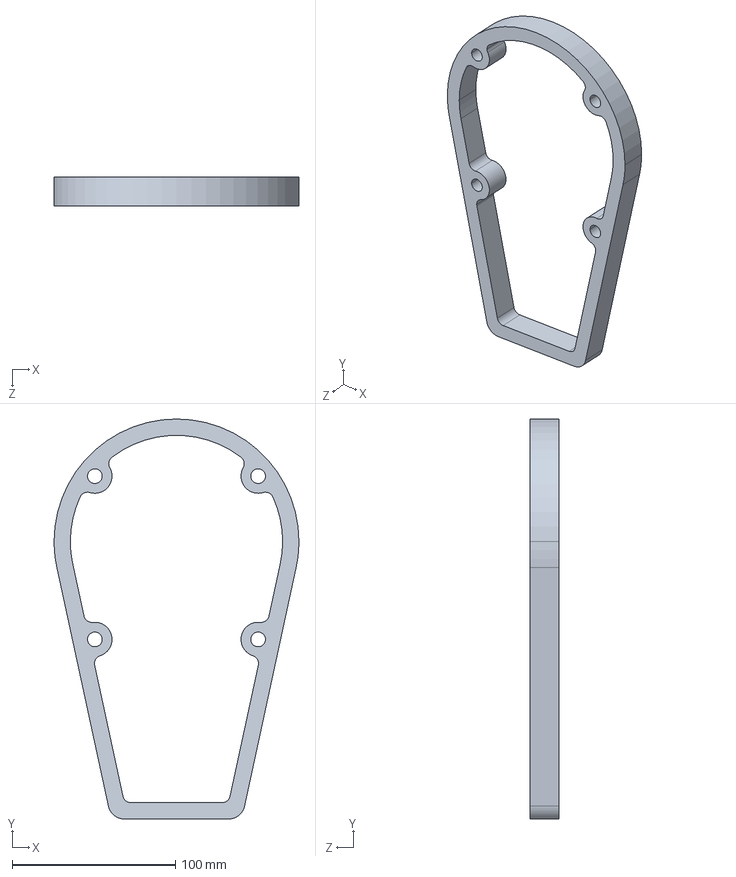
[picture p49: CAD file, 2017-11-05]
CAD/J1 base support spacer.STEP
150.0 x 245.0 x 18.0 mm
