MarkVerbeek91/AR2/CAD/J2 Spring housing.STEP

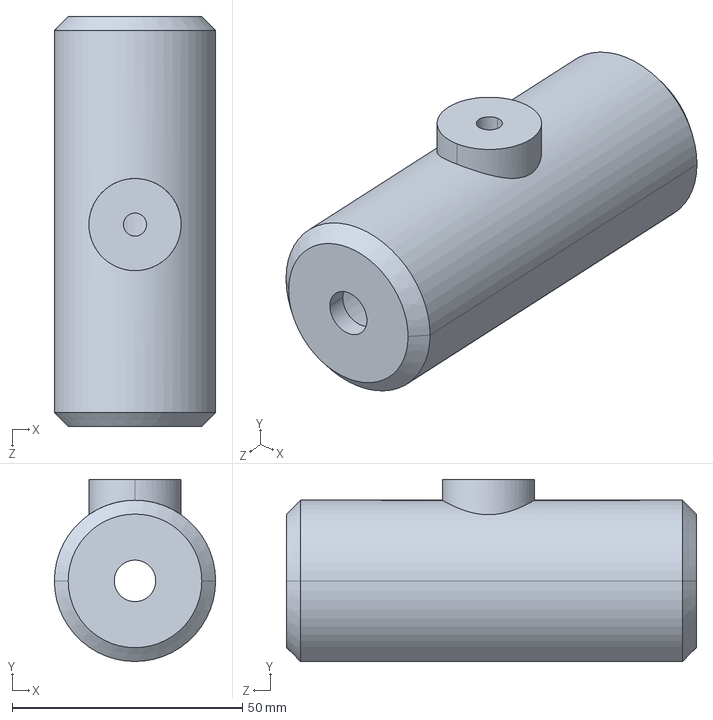
[picture p50: CAD file, 2017-11-05]
CAD/J2 Spring housing.STEP
35.0 x 39.5 x 89.0 mm
