MarkVerbeek91/AR2/CAD/J2 motor support.STEP

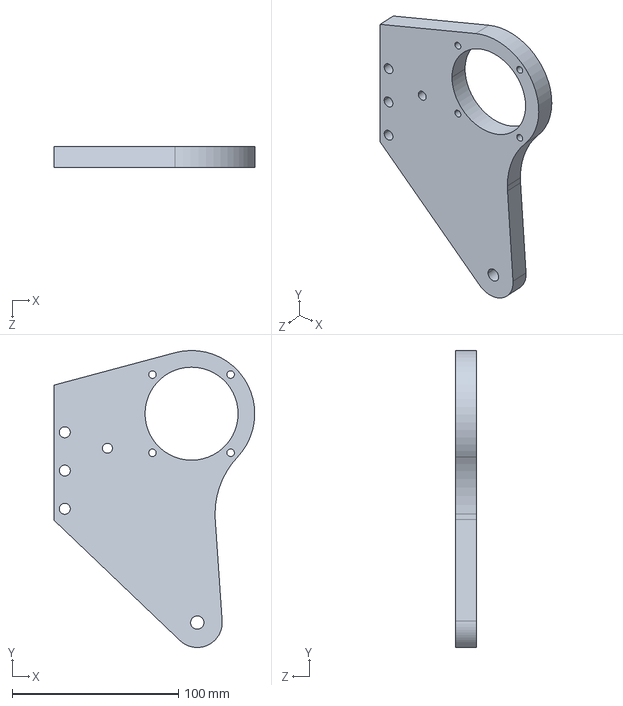
[picture p51: CAD file, 2017-11-05]
CAD/J2 motor support.STEP
120.6 x 178.6 x 12.7 mm
