MarkVerbeek91/AR2/CAD/J6 housing single piece.STEP

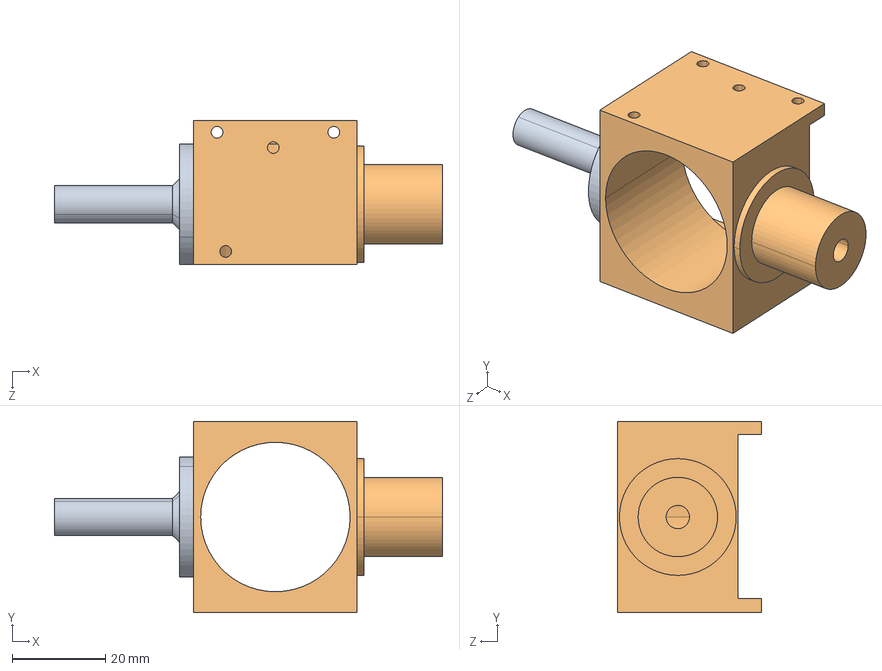
[picture p52: CAD file, 2017-11-05]
CAD/J6 housing single piece.STEP
83.1 x 41.0 x 30.8 mm
