MarkVerbeek91/AR2/CAD/J2 Motor Spacer.STEP

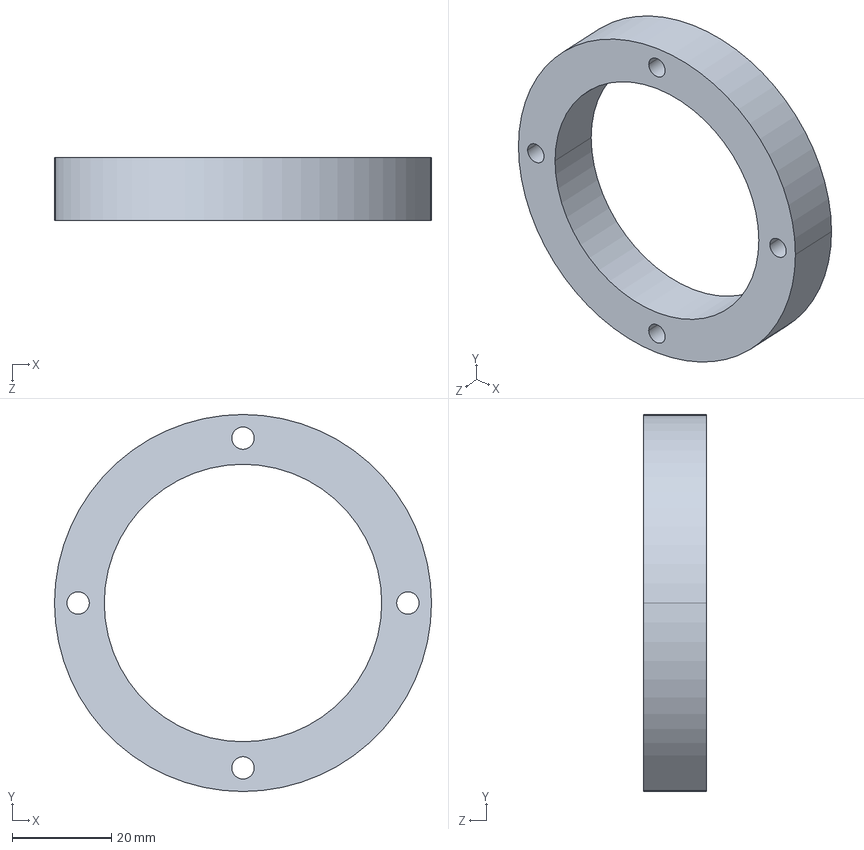
[picture p53: CAD file, 2017-11-05]
CAD/J2 Motor Spacer.STEP
76.0 x 76.0 x 12.7 mm
