MarkVerbeek91/AR2/CAD/J5 housing.STEP

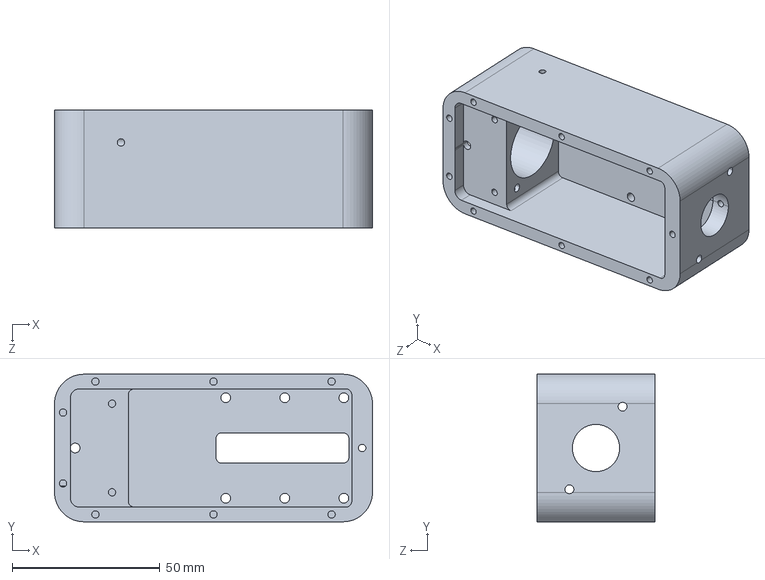
[picture p54: CAD file, 2017-11-05]
CAD/J5 housing.STEP
107.7 x 50.0 x 40.0 mm
