MarkVerbeek91/AR2/CAD/J2 arm.STEP

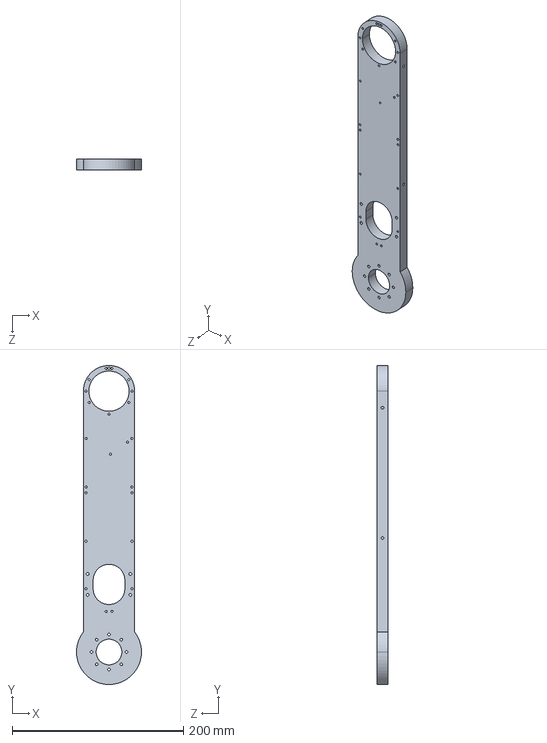
[picture p55: CAD file, 2017-11-05]
CAD/J2 arm.STEP
76.0 x 373.0 x 12.7 mm
