MarkVerbeek91/AR2/CAD/J2 side cover.STEP

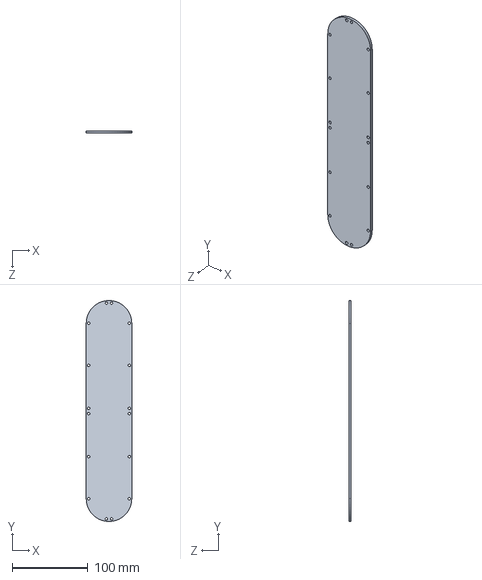
[picture p57: CAD file, 2017-11-05]
CAD/J2 side cover.STEP
60.0 x 291.0 x 3.17 mm
