MarkVerbeek91/AR2/CAD/J3 spindle retainer.STEP

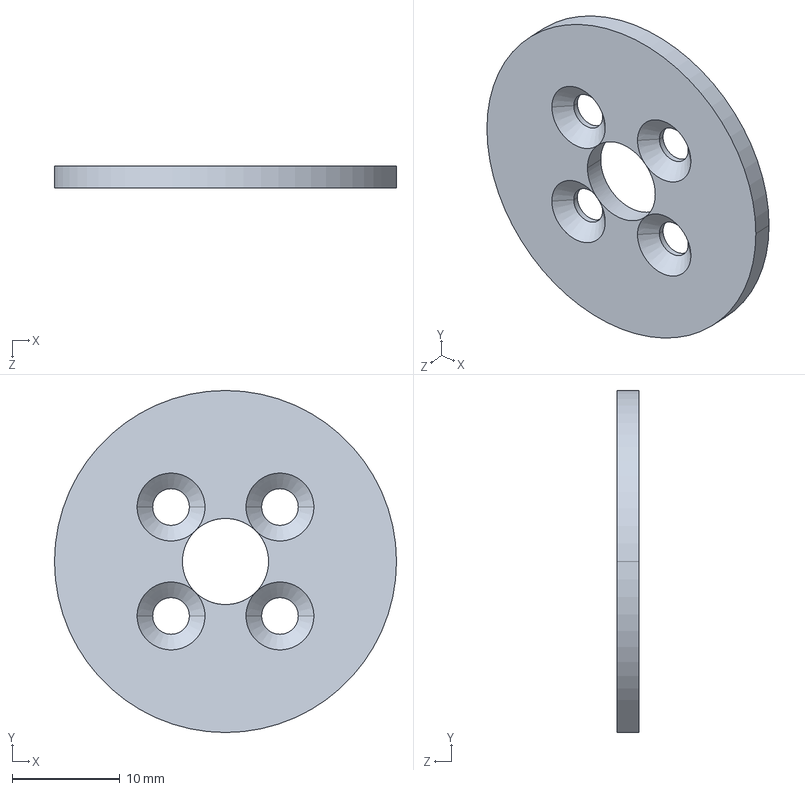
[picture p58: CAD file, 2017-11-05]
CAD/J3 spindle retainer.STEP
31.8 x 31.8 x 2.00 mm
