MarkVerbeek91/AR2/CAD/J4 motor mount - limit arm.STEP

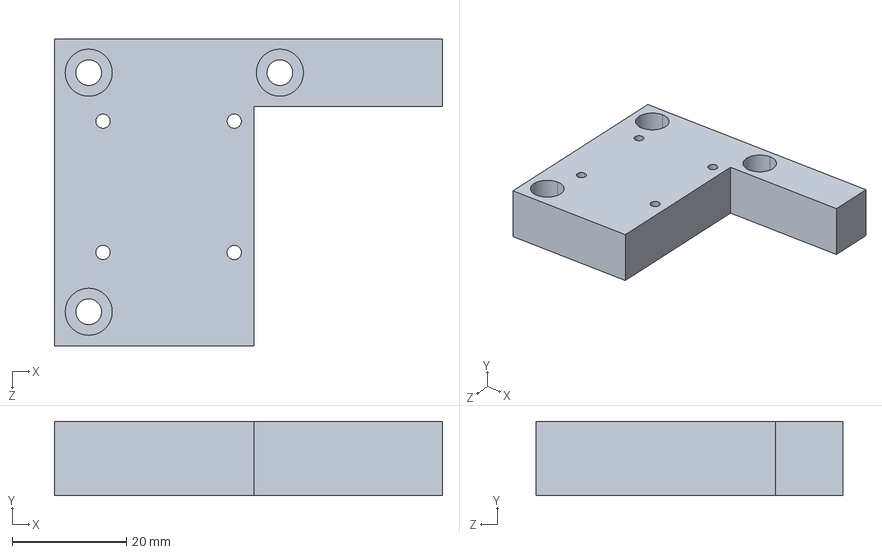
[picture p59: CAD file, 2017-11-05]
CAD/J4 motor mount - limit arm.STEP
68.0 x 13.0 x 53.8 mm
