MarkVerbeek91/AR2/CAD/J2 drive spindle - precision GB .STEP

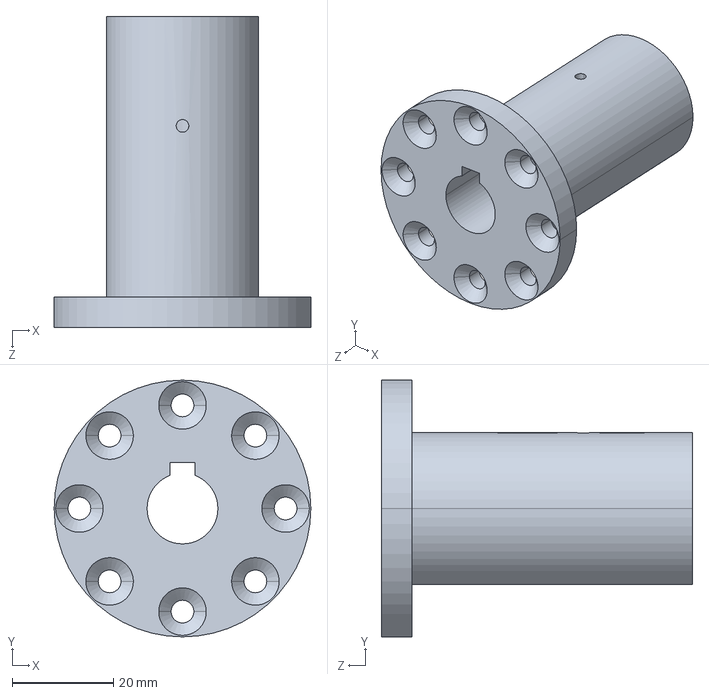
[picture p60: CAD file, 2017-11-05]
CAD/J2 drive spindle - precision GB .STEP
50.8 x 50.8 x 61.5 mm
