MarkVerbeek91/AR2/(list of files, cad)

Other CAD files:
CAD/J1 platform support.STEP
CAD/J3 turret housing.STEP
CAD/J2 Delrin washer.STEP
stl/J1 & J3 motor mount - precision GB.STL
stl/J1 motor mount.STL
stl/J1 spindle.STL
stl/J1 turret housing.STL
stl/J1 turret platform.STL
stl/J2 Spring housing.STL
stl/J2 arm cover spacer.STL
stl/J2 drive spindle .STL
stl/J2 motor support.STL
stl/J2 side cover.STL
stl/J2 tension ring.STL
stl/J2 turret housing.STL
stl/J3 bearing cup.STL
stl/J3 motor mount.STL
stl/J3 spindle retainer.STL
stl/J3 spindle.STL
stl/J4 motor mount - limit arm.STL
stl/J4 timing hub.STL
stl/J4 turret housing.STL
stl/J5 bearing post.STL
stl/J5 belt carrier.STL
stl/J5 housing.STL
stl/J5 idler tension block.STL
stl/J5 main bearing housing.STL
stl/J5 motor mount.STL
stl/J5 side cover cap.STL
stl/J5 side cover spacer.STL
stl/J5 side cover.STL
stl/J6 Limit Switch Tip.STL
stl/J6 bearing cap.STL
stl/J6 gripper mount.STL
stl/J6 main bearing arm.STL
