MarkVerbeek91/AR2/Manual - AR2 Travel Track.pdf

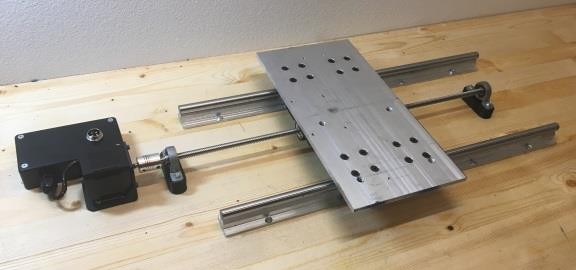
[picture p61: figure]

# Model AR2 Travel Track

Travel Track
Manual | 1

### NOTE:

### This manual shows the construction of the AR2 travel track using 500mm length guides but you can build the track any length you want. Tack can be screw drive

as shown or you can design your own track or use a belt drive if desired.

### Any stepper motor can be used as long as its wired as shown and in the

electrical enclosure manual.

### - 3D printed components require all threaded holes to be cleared with

appropriate drill size.

### - All printed components were printed at minimum 50% solid at 2mm layer

height and thick shells.

# BILL OF MATERIALS

# Plastic Components

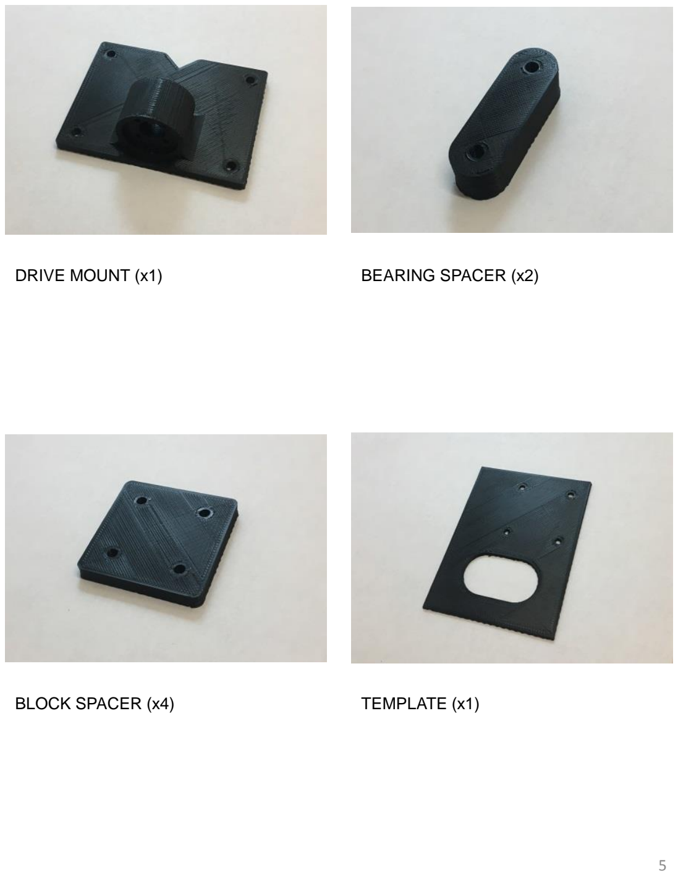
[picture p62: page 5]

DRIVE MOUNT (x1) | BEARING SPACER (x2)
BLOCK SPACER (x4) | TEMPLATE (x1)

# Stepper Motors

# Stepper motors as well as stepper drivers and brackets are available from Stepper Online

# http://www.omc-stepperonline.com/

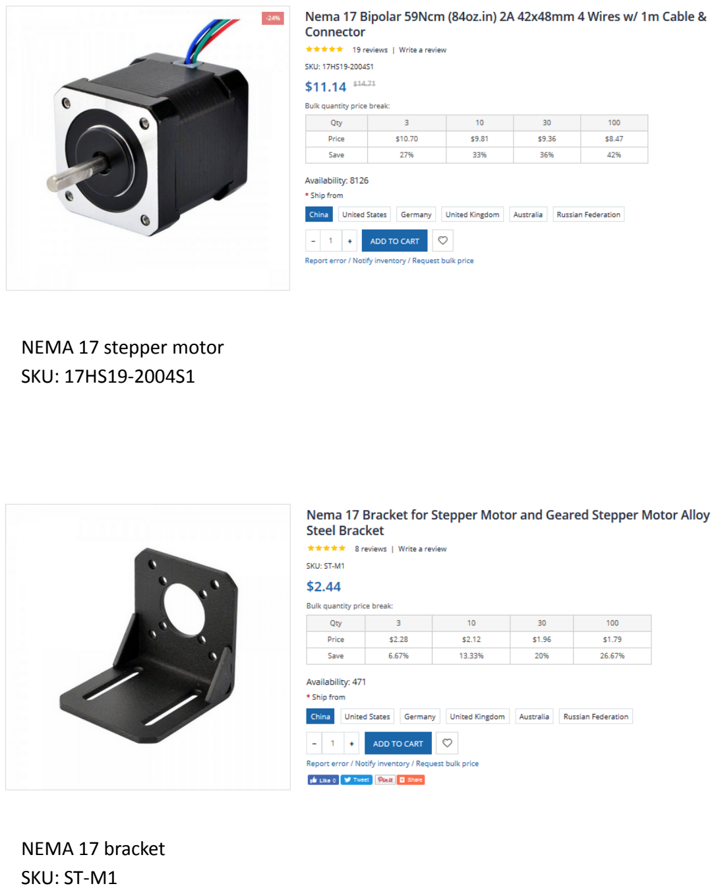
[picture p63: page 7]

### NEMA 17 stepper motor SKU: 17HS19-2004S1

### NEMA 17 bracket SKU: ST-M1

# Hardware

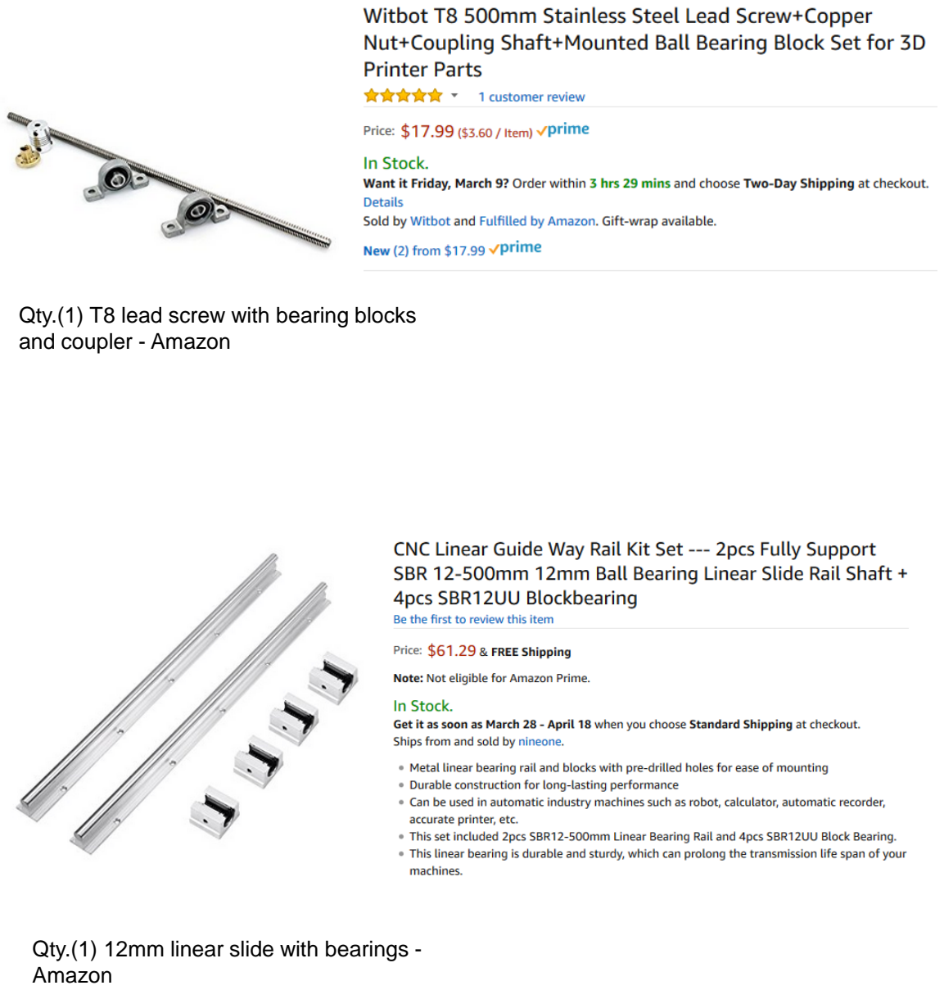
[picture p64: page 9]

Qty.(1) T8 lead screw with bearing blocks and coupler - Amazon

Qty.(1) 12mm linear slide with bearings -Amazon

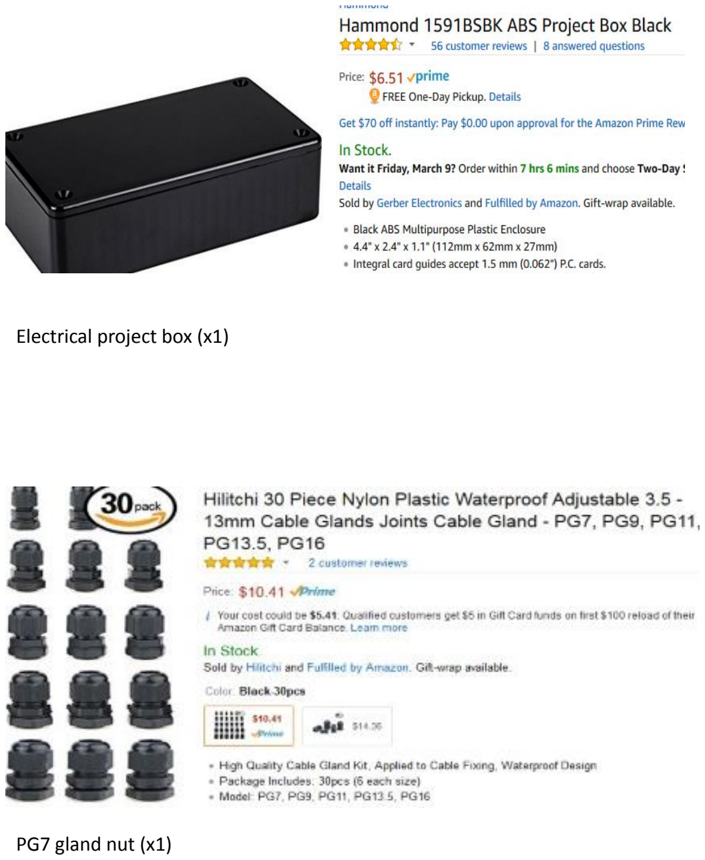
[picture p65: page 10]

### Electrical project box (x1)

### PG7 gland nut (x1)

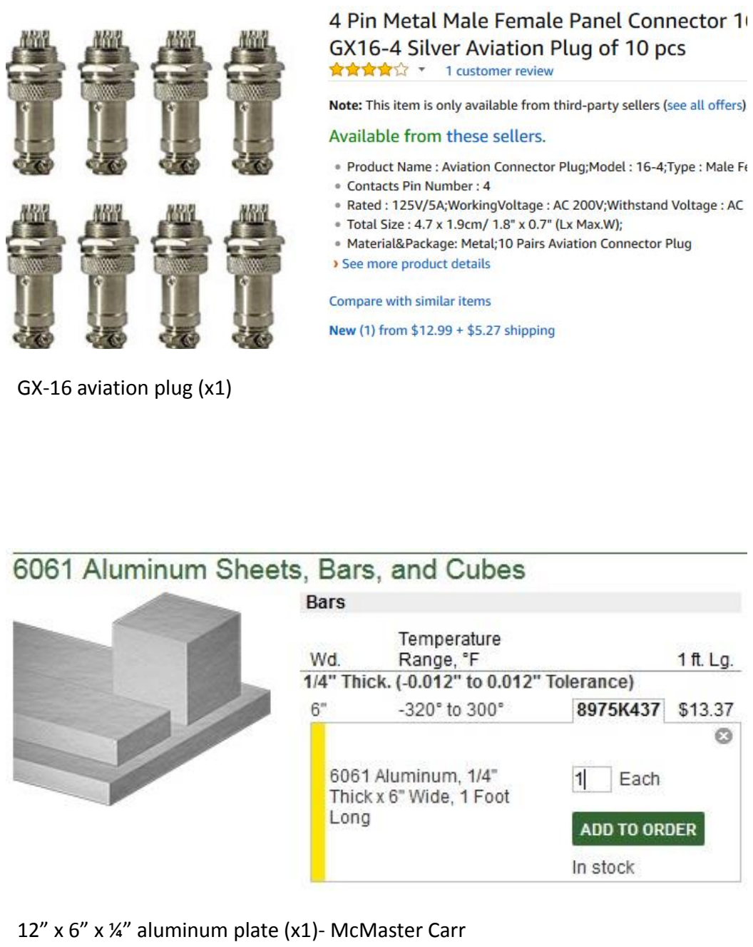
[picture p66: page 11]

### GX-16 aviation plug (x1)

### 12” x 6” x ¼” aluminum plate (x1)- McMaster Carr

# ASSEMBLY

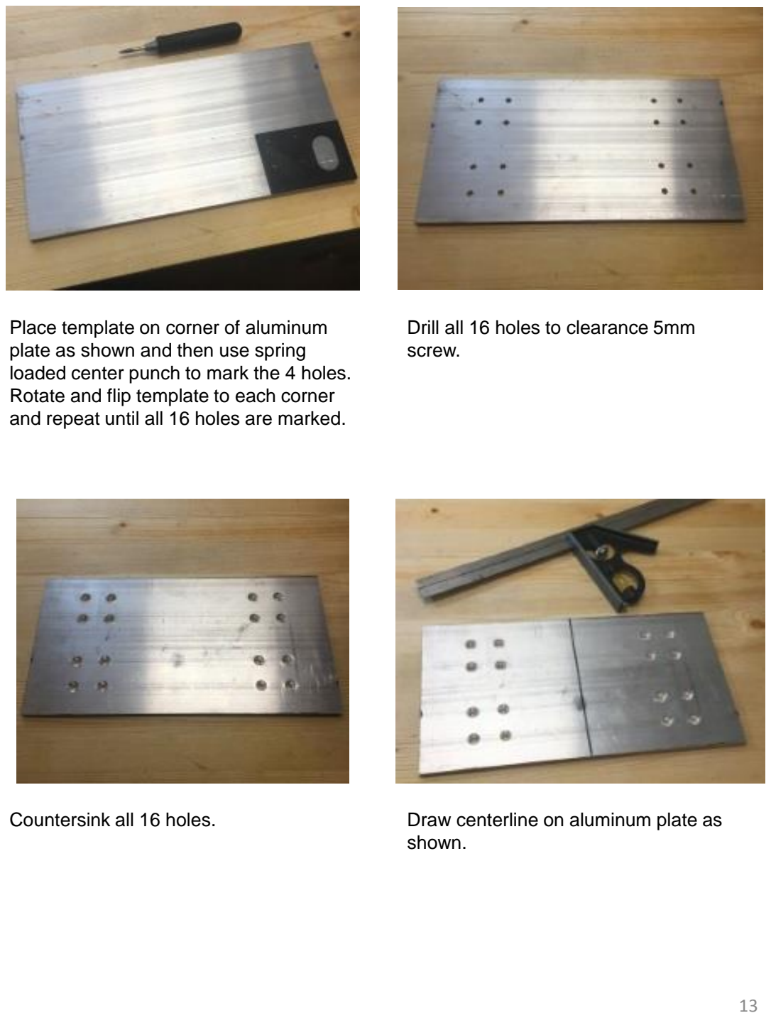
[picture p67: page 13]

Place template on corner of aluminum plate as shown and then use spring loaded center punch to mark the 4 holes. Rotate and flip template to each corner and repeat until all 16 holes are marked.

Drill all 16 holes to clearance 5mm screw.

Countersink all 16 holes. | Draw centerline on aluminum plate as shown.

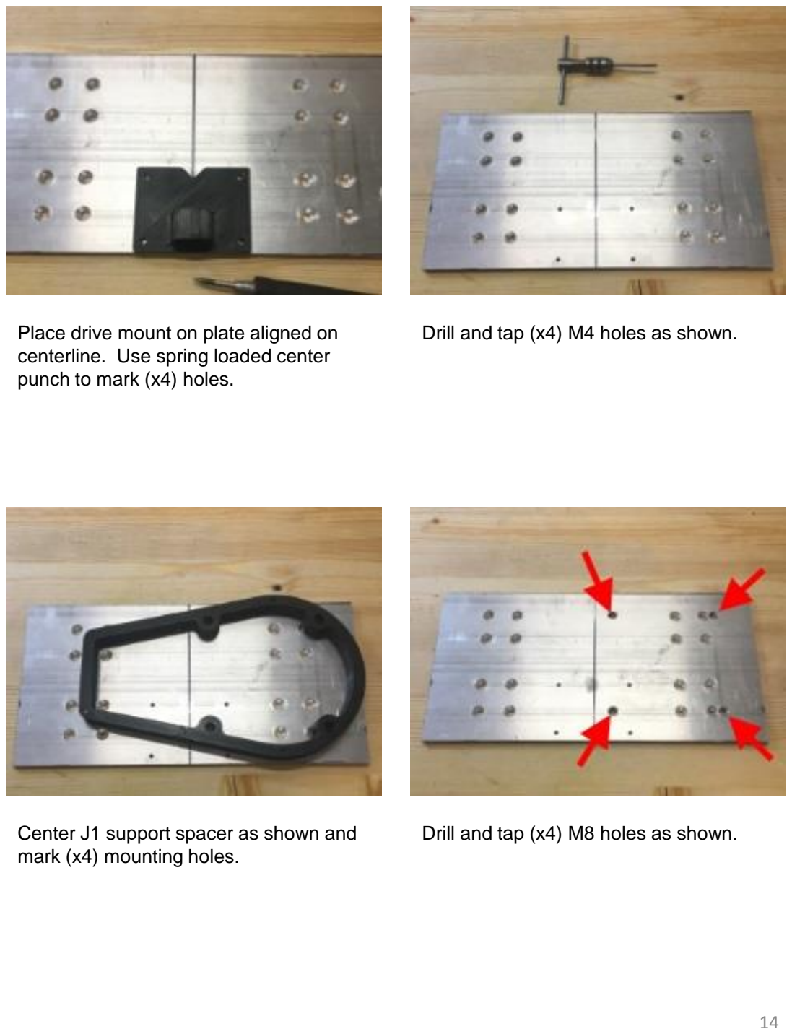
[picture p68: page 14]

Place drive mount on plate aligned on centerline. Use spring loaded center punch to mark (x4) holes.

Drill and tap (x4) M4 holes as shown.

Center J1 support spacer as shown and mark (x4) mounting holes.

Drill and tap (x4) M8 holes as shown.

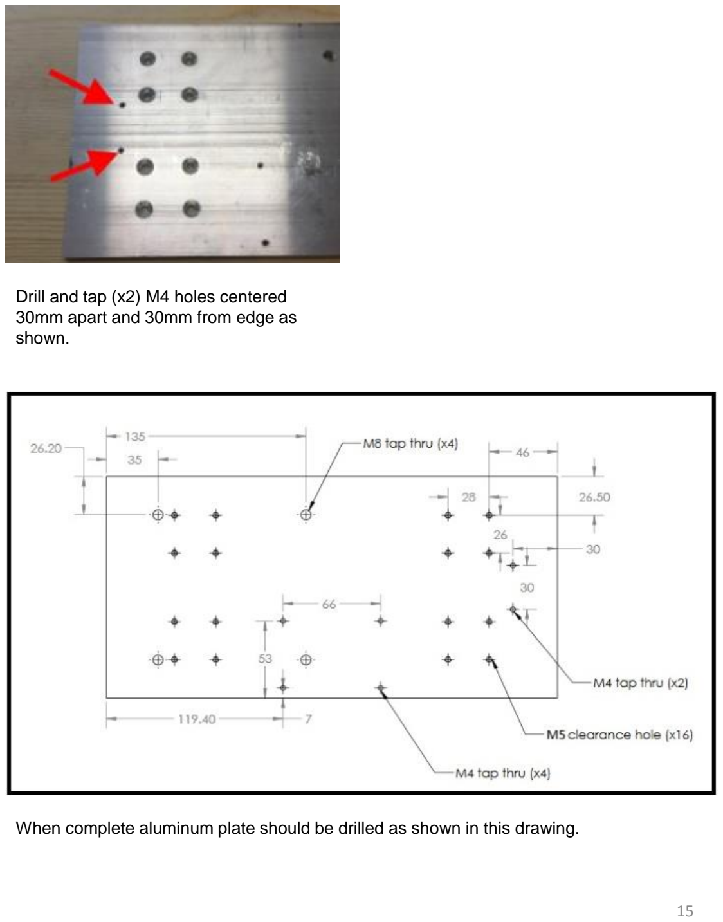
[picture p69: page 15]

Drill and tap (x2) M4 holes centered 30mm apart and 30mm from edge as shown.

When complete aluminum plate should be drilled as shown in this drawing.

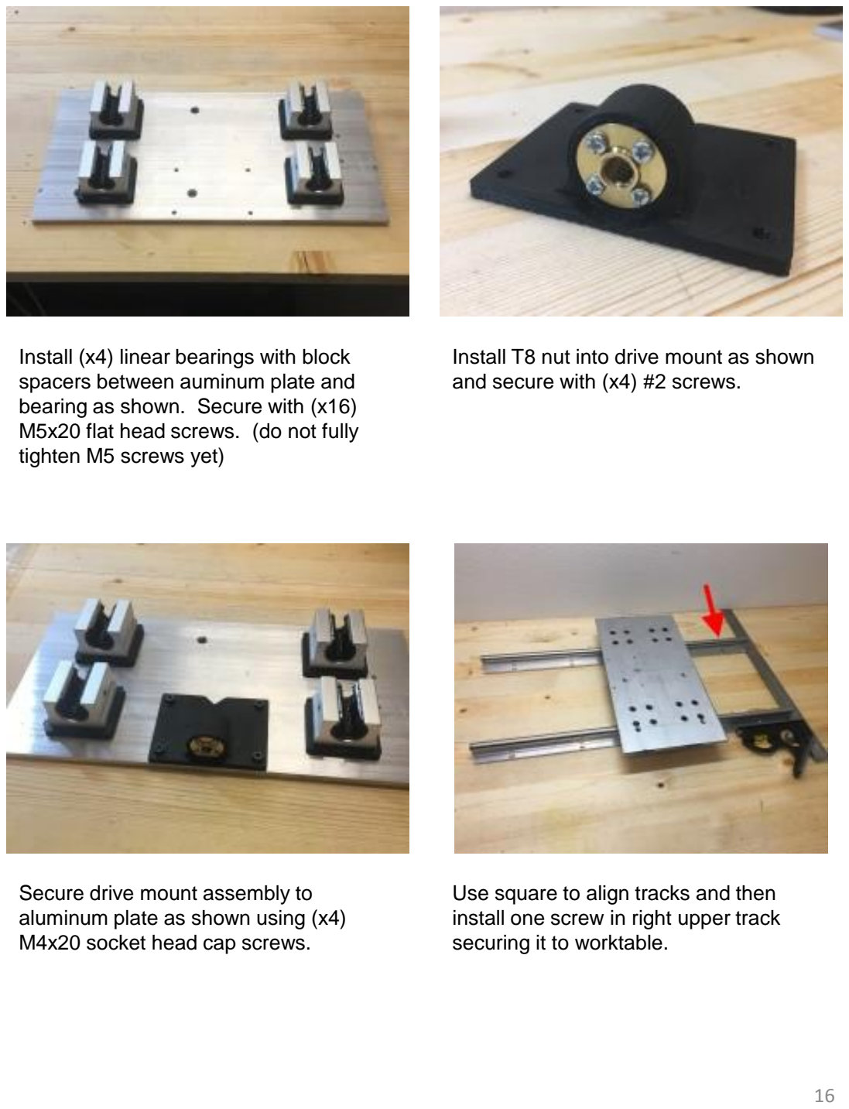
[picture p70: page 16]

Install (x4) linear bearings with block spacers between auminum plate and bearing as shown. Secure with (x16) M5x20 flat head screws. (do not fully tighten M5 screws yet)

Install T8 nut into drive mount as shown and secure with (x4) #2 screws.

Secure drive mount assembly to aluminum plate as shown using (x4) M4x20 socket head cap screws.

Use square to align tracks and then install one screw in right upper track securing it to worktable.

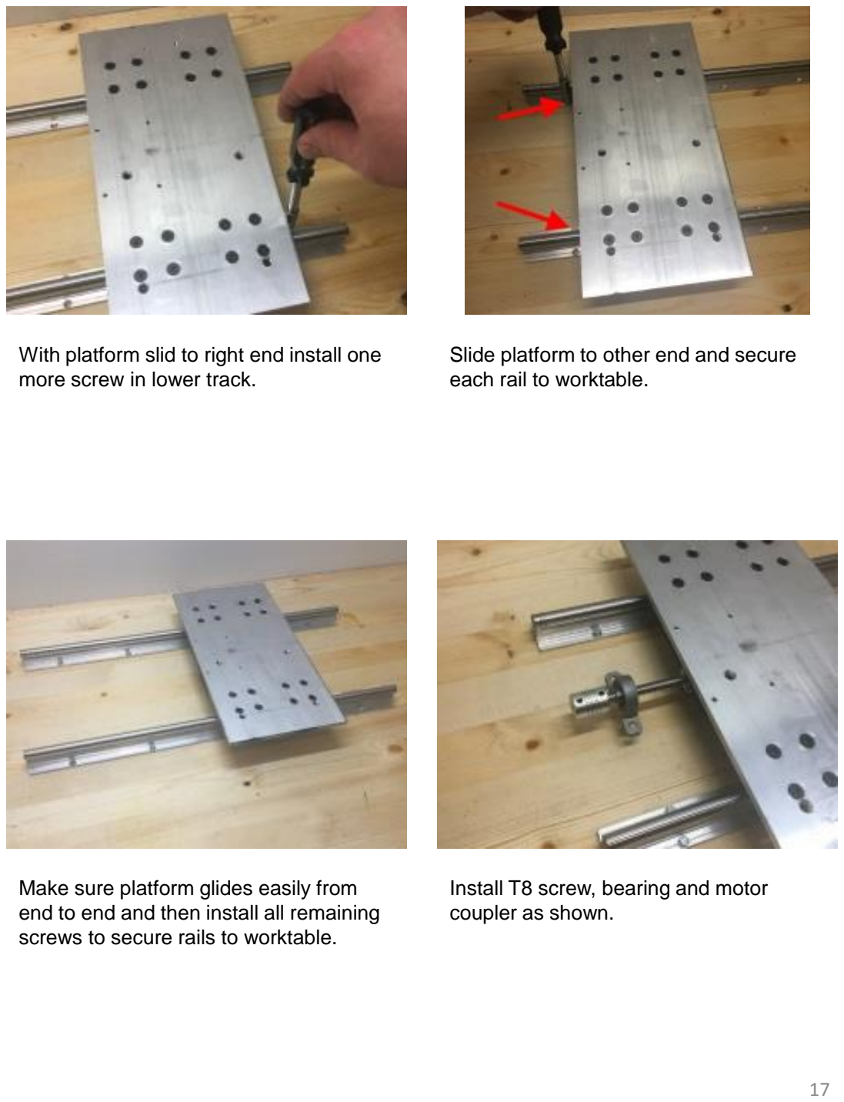
[picture p71: page 17]

With platform slid to right end install one more screw in lower track.

Slide platform to other end and secure each rail to worktable.

Make sure platform glides easily from end to end and then install all remaining screws to secure rails to worktable.

Install T8 screw, bearing and motor coupler as shown.

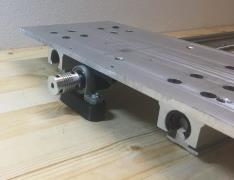
[picture p72: figure]

With platform at maximum travel to the left side secure lead screw bearing and bearing spacer to work table as shown.

Tighten bearing and coupler set screws.

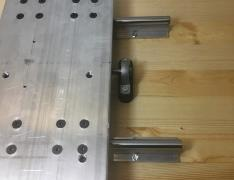
[picture p73: figure]

Turn screw manually and drive platform to far end. Secure opposite lead screw bearing and bearing spacer as shown at very end of screw.

Tighten bearing set screws.

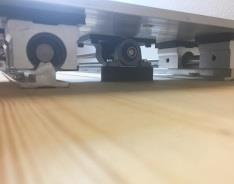
[picture p74: figure]

Note that the drive mount should bottom out against the bearing and not allow the platform to go off the end of the rails.

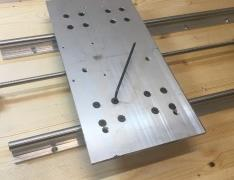
[picture p75: figure]

Make sure platform moves smoothly and easily down rails and then tighten the (x16) M5 screws securing platform to rail bearings.

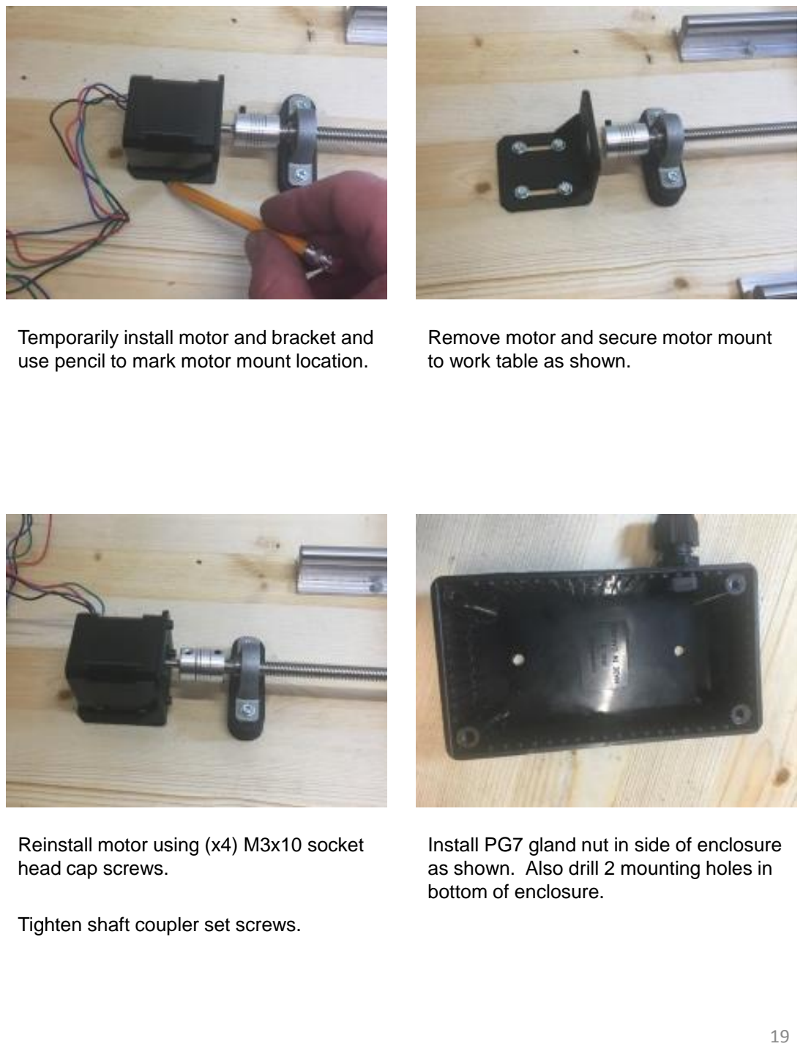
[picture p76: page 19]

Temporarily install motor and bracket and use pencil to mark motor mount location.

Remove motor and secure motor mount to work table as shown.

Reinstall motor using (x4) M3x10 socket head cap screws.

Tighten shaft coupler set screws.

Install PG7 gland nut in side of enclosure as shown. Also drill 2 mounting holes in bottom of enclosure.

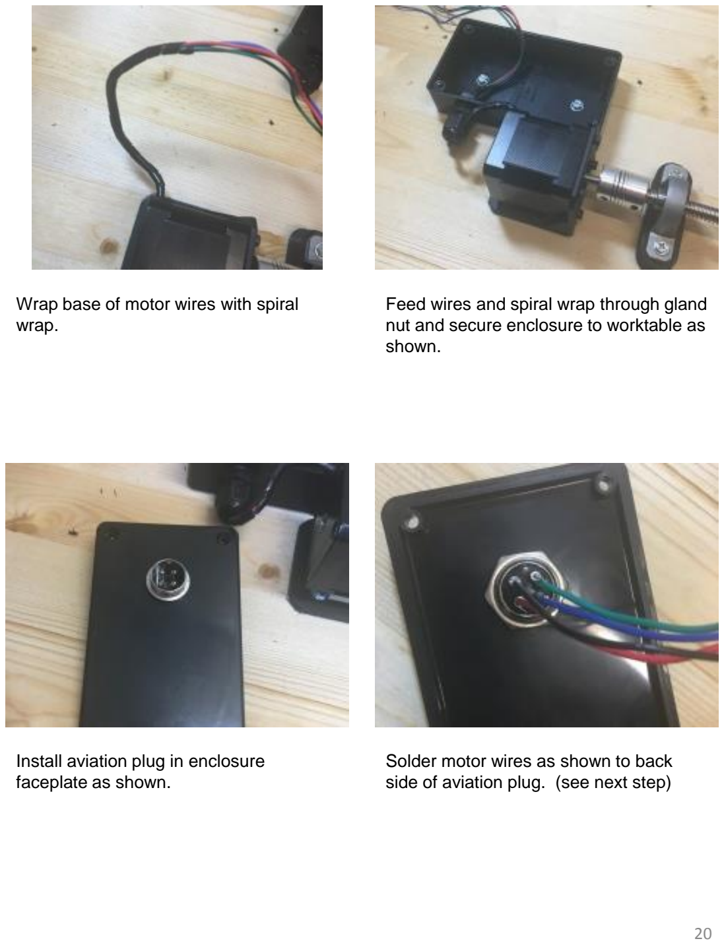
[picture p77: page 20]

Wrap base of motor wires with spiral wrap.

Feed wires and spiral wrap through gland nut and secure enclosure to worktable as shown.

Install aviation plug in enclosure faceplate as shown.

Solder motor wires as shown to back side of aviation plug. (see next step)

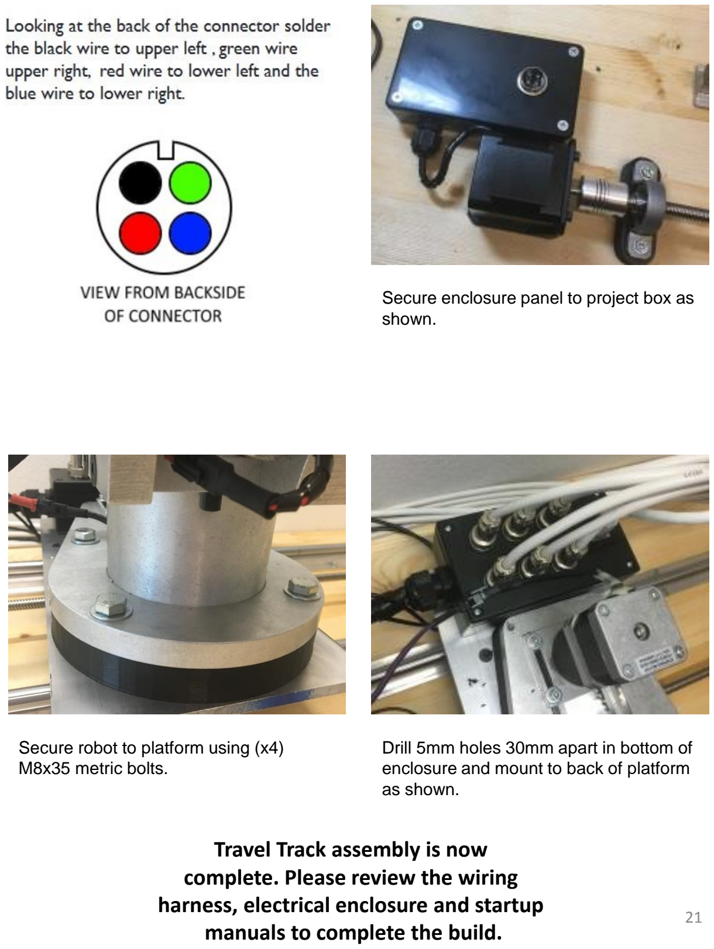
[picture p78: page 21]

Secure enclosure panel to project box as shown.

Secure robot to platform using (x4) M8x35 metric bolts.

Drill 5mm holes 30mm apart in bottom of enclosure and mount to back of platform as shown.

## Travel Track assembly is now complete. Please review the wiring harness, electrical enclosure and startup

manuals to complete the build.
