MarkVerbeek91/AR2/docs/doc/source/test_cases.rst

==========
Test cases
==========

Controller
==========================

A programm containning one program line
  each of the individual 'execure commands'
  
A programm contraining program flow 
  if statement
  loop
  
Programmer 
==========================

Create new program

Delete program

Load existing program

GUI
==========================

Joint 
==========================

Serial Communications
==========================
Send command 
Recieve responce
