MarkVerbeek91/AR2/images/Defaut Calibration Settings AR2 (with 3 precision series motors & DM542T drives).jpg

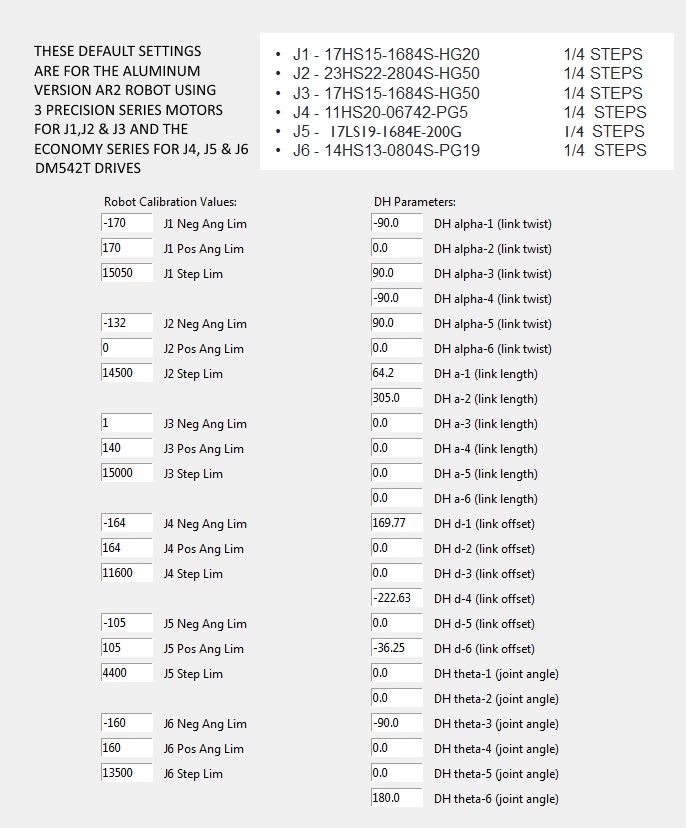
images/Defaut Calibration Settings AR2 (with 3 precision series motors & DM542T drives).jpg
