MarkVerbeek91/AR2/images/Defaut Calibration Settings AR2 (with economy series motors & ST-6600 drives).jpg

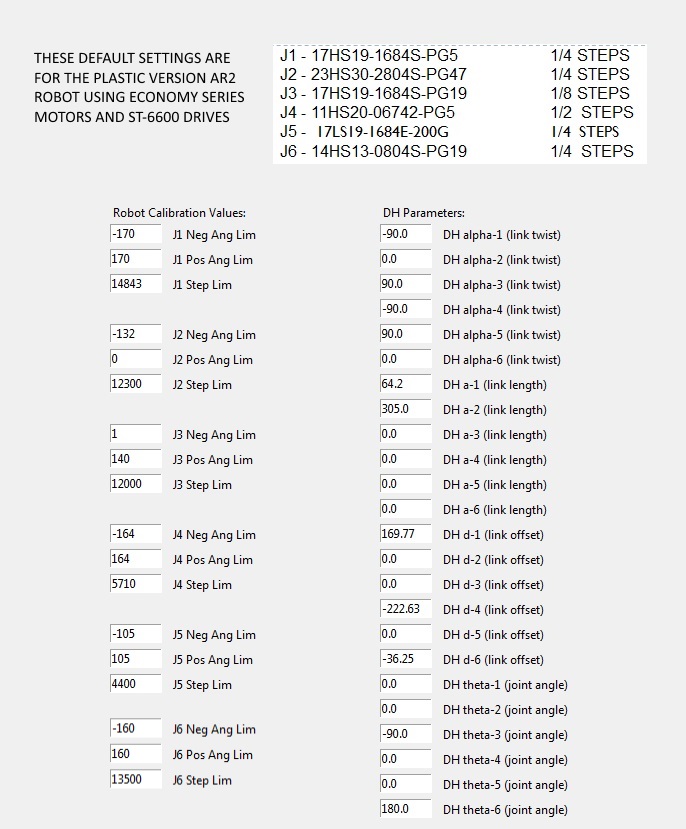
images/Defaut Calibration Settings AR2 (with economy series motors & ST-6600 drives).jpg
