MarkVerbeek91/AR2/tests/test_gui.py

# new version control

import sys

sys.path.append('../src')


from gui import GuiAR2

def assert_gui_creation():
  """
  """
  assert False

def test_gui_creation():
  """
  """
  # ar2_gui_obj = GuiAR2()

  assert True

def test_gui_init():
  """
  """
