MarkVerbeek91/AR2/(commit log)

2017-11-05 commited stl files on individual basis
    [J1 & J3 motor mount - precision GB.STL, J1 base plate part 1.STL, J1 base plate part 2.STL, J1 base support spacer part 1.STL, J1 base support spacer part 2.STL, J1 motor mount.STL, J1 spindle center alignment plug.STL, J1 spindle.STL]
2017-11-05 commit step file on indivial basis
    [J1 & J3 motor mount - precision GB.STEP, J1 base plate.STEP, J1 base support spacer.STEP, J1 motor mount.STEP, J1 platform support.STEP, J1 spindle.STEP, J1 turret housing.STEP, J1 turret platform.STEP]
2017-11-05 moved manuals to docs\., removed step and stl zips
    [AR2 kinamatic model.xlsm]
2017-11-07 repo cleanup and move of manuals to folder
    [AR2 kinamatic model.xlsm]
2017-11-07 now really removed files
    [AR2 kinamatic model.xlsm]
2017-11-21 rename arduino main file
2017-11-28 AR2.py backwards comp with python27, fix conf file
    [AR2.py]
2017-11-28 start added buttons + programmer functions
2017-12-04 some minor inprovements
    [conf_commands.csv]
2017-12-04 labels via conf file, name fix labels conf file
    [conf_tab1_entries.csv, conf_tab1_labels.csv]
2017-12-04 buttons now also made with conf file
    [conf_tab1_buttons.csv]
2017-12-06 simple start and stop buttons, not working yet
    [gui.py, programmer.py]
2017-12-07 increased functional buttons, sort of
    [conf_tab1_buttons.csv]
2017-12-15 new _commands structure, now dict instead of list
    [conf_commands.csv]
2017-12-15 added loading of program at startup
    [conf_commands.csv]
2018-01-12 unittests fix for programmer and customr serial
    [controller.py, programmer.py, test_programmer.py, test_serial_custom.py]
2018-02-14 fixed all tests, worked on code coverage
    [controller.py, serial_custom.py, test_controller.py, test_gui.py, test_joint.py, test_main.py, test_program.py, test_programmer.py]
